sprabha5/High-Voltage-Isolated-Differential-Probe/Publication/Publication_Research_paper.pdf

# Ultra Low-Cost High-Voltage Isolated Differential Probe for Teaching and Training

Mouli Venkata Prakash Pittala, Devi Prasad Karri, Shashi Prabha, Daniel Dsa, Little Pradhan, and Abhijit Kshirsagar

Department of Electrical Engineering, Indian Institute of Technology (IIT), Dharwad, Karnataka, India

Emails: {200020027,200020022,200020043,daniel.dsa,little.pradhan.20,kabhijit}@iitdh.ac.in

Abstract—Measurement of time-varying high-voltages is necessary in various teaching, training, and research scenarios, in domains ranging spanning multiple disciplines beyond just electric power engineering. While low voltage levels (<100V) can usually be measured directly by oscilloscopes with inexpensive passive probes, higher voltages (>400V) often require specialized probes and/or oscilloscopes which are expensive. Also, most oscilloscopes lack galvanically isolated channels, which adds further challenges to measurement of multiple floating (not grounded) high voltages. Although both problems can be solved by differential high-voltage probes, these are quite expensive and not cost-effective for teaching laboratories where large numbers of such probes may be needed. This paper presents a novel, inexpensive isolated high-voltage differential probe intended for use in undergraduate and graduate labs in Power Electronics, Electric Machines and Drives, Renewable Energy, etc. It is designed for input voltages up to 600V with a bandwidth of 350KHz. The design is self-contained with a removable lithium-ion battery and is designed to directly interface to a standard oscilloscope. The design also includes gain and offset correction for periodic calibration. Simulation results were validated using a preliminary hardware prototype, following which a compact version was created with optimized layout. This design is found to be excellent for cost-sensitive applications including universities, makerspaces, and startups and industries.

Index Terms—High Voltage (HV) measurement, Differential probe, Isolation amplifier, Teaching and Training

I. INTRODUCTION
High-voltage signals are common in diverse applications spanning power electronics, electric drives, renewable energy systems, and high-voltage equipment. High voltages are also common in many consumer electronics that contain large displays or motor drives. Advancements in power electronics and newer wide-band-gap semiconductors have spurred a move to higher system voltages. As an example, within two decades, electric vehicles have moved from 48V or 96V onto 400V and now even 800V systems [1]. Solar photovoltaic systems, which were once limited to 400V, are trending over 1500V [2]. Measuring such time-varying high voltages is essential

This work was partially supported through Startup Research Grant (SRG/2020/002232) from the Science and Engineering Research Board (Department of Science and Technology, Government of India) and TiHAN Scientific and Industrial Research Organization (SIRO) by the Department of Scientific and Industrial Research.

not only for product development, research and testing, but also in teaching and training. The most common method for measuring such time-varying high-voltage signals is to use an oscilloscope with a dedicated high-voltage probe. In addition, since many of these high voltages are floating (i.e. not referenced to the common earth ground), it is necessary to use a differential probe. Additionally, if multiple voltages with different references are to be captured on a single oscilloscope, then the probes may need to be galvanically isolated as well [3]. To meet these stringent requirements, a number of specialized high-voltage probes have been developed. Most of these commercially available probes are quite expensive (well over USD 1000) [4]. Recently, optically isolated high-voltage high-bandwidth probes have been introduced [5], [6] with even better performance and prices to match (>USD 10,000). These are well out of reach for cost-sensitive buyers such as educational labs, maker-spaces, hobbyists, and earlystage hardware startups, hence there is a need for a lower bandwidth, lower voltage solution and cost-effective solution for this target market.
The dual differential probe presented in [7] has a 10MHz bandwidth and 7.3V/ns slew rate using high-performance analog amplifiers. The frontend uses carefully designed resistive dividers to attenuate the voltage appearing at the input of the op-amp. This design is not truly isolated and the dependence on very-high bandwidth op-amps drives up the BOM cost. Further, for lower voltages the attenuation cannot be lowered by bypassing resistors since the probe is not truly isolated. A similar approach, without galvanic isolation, is developed in [8], [9].
True galvanic isolation is desirable particularly for limiting common-mode noise, especially in high slew-rate applications like WBG measurements. Here, analog-to-digital conversion followed by optical transmission of the digital data yields the best performance [10]. However, the high sampling rate required, (along with the complexity of recovering the signal on the other end on a host device with GUI software) drives up the cost.
In [4] a high common-mode voltage active differential probe is presented that allows a standard oscilloscope to display and quantify waveforms in circuits . It supports bandwidths up
979-8-3503-1057-3/23/$31.00 ©2023 IEEE | to 100 MHz and can reliably measure differential voltages

up to 1000 V AC and 1400 V AC/DC. In [11] a novel fiber-coupled sensor utilizing the Pockels effect in lithium niobate crystal enables direct, contactless, and high-bandwidth (GHz to DC) measurement of High Voltage (45kV) through light modulation, eliminating voltage dividers and physical connections, ideal for isolated and unobtrusive voltage sensing in various applications.
This paper presents a much lower cost, galvanically isolated probe primarily for educational use. True galvanic isolation makes it possible to measure multiple floating voltages simultaneously on one oscilloscope - for example when measuring three phase voltages and one DC-link voltage in an inverter-fed drive; or primary and secondary voltages on a transformer, etc. Voltage levels in such applications are usually 400V (threephase) or lower; hence the proposed design is targeted for 600V. Switching voltages are or the order of few tens of kilohertz, hence a system bandwidth of 300kHz is used. The ‘high’-side of the probe is powered by a removable, rechargeable lithium ion battery, making it self contained. Finally, the probe incorporates gain and offset correction circuits to improve the accuracy of differential voltage measurements using potentiometers, again keeping cost low. The probe presents high input impedance and minimizing adverse loading effects on the measured circuit, ensuring the preservation of signal integrity during analysis.

II. PROPOSED HIGH VOLTAGE PROBE WITH ISOLATION

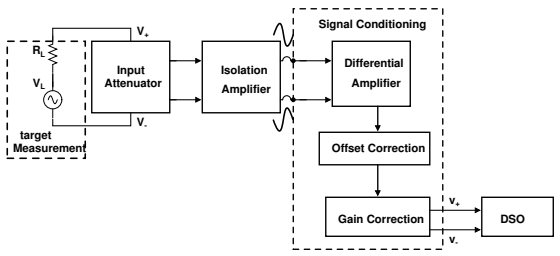
[picture p3: figure]
Differential; Amplifier; Gain Correction; DSO; Isolation; Offset Correction; Input; target Measurement; Attenuator; Signal Conditioning

Fig. 1. Block diagram of the proposed high voltage probe
Fig 1 illustrates the block diagram of the proposed HV probe. The design consists of an attenuator stage, followed by an isolation stage and a differential amplifier. The attenuator stage is responsible for reducing the voltage level, while the isolation stage ensures capacitive isolation between the probe and the measurement circuit. The differential amplifier is used to achieve ground referencing and amplify the signal. Furthermore, the design includes an offset correcting circuit to enable DC level shift and a gain correcting circuit. The probe achieves a magnification factor of 250x by maintaining unity gain correction. The proposed probe can provide isolation up to a voltage rise of 2100V, as the isolation amplifier used in the design supports such high isolation levels.
A. Attenuator
The input range of the isolation amplifier is limited between +300mV and -300mV, and therefore the high input voltage needs to be attenuated to the desired range. As shown in

Fig 2, the attenuator circuit consists of eight series-connected 250kΩ resistors and one 1kΩ resistor. The input voltage across the 1kΩ resistor is then fed to the isolation amplifier. The attenuation factor can be calculated using the following equation:

Attenuation factor =

Rinput

Rtotal + Rinput

(1)

where Rtotal is the total resistance of the attenuator circuit (8 x 250kΩ) and Rinput is the resistance across which the input voltage is applied (1kΩ). This yields an attenuation factor approximately equal to 2000. The input voltage range of the HV probe can be calculated as:

Input range of HV Probe = 2000 × (-300mV, +300mV) (2)

where (-300mV, +300mV) is the input voltage range of the isolation amplifier. The proposed HV probe can therefore measure input voltage signals in the range of -600V to +600V.

B. Isolation Amplifier

Isolation is provided by the AMC1301 isolation amplifier, from Texas Instruments. The AMC1301 requires a +5V power supply, which is generated using the LM7805 regulator. Fig 4 demonstrates the gain value of the isolation amplifier to be 18.6 dB, from LTspice simulation. The voltage gain is therefore 8, up to 100 KHz.
Fig 5 shows the LC low-pass filter employed in the power supply to eliminate undesired noise signals before they reach the isolation amplifier. To ensure that only DC signals are permitted, the cutoff frequency of the LC low-pass filter is set as low as possible. The specified cutoff frequency of the LC filter is as follows.
C = C1 + C2 + C3 | (3)
= 470µF + 0.1µF + 0.01µF
= 470.1µF

Now, using the combined capacitance (C = 470.1µF) and the value of the inductor (L = 1mH), the cutoff frequency of the LC low-pass filter using is calculated using the formula:

fc =

1
2π

√
L · C

=

1
2π

√
1mH · 470.1µF

≈

1
2π · 154.167kHz

≈ 1.03kHz (4)

C. Differential Amplifier

The initial step in the signal conditioning process as shown in Fig 1 involves utilizing a differential amplifier to convert the differential input into a ground-referenced signal which allows the signal to be fed into an oscilloscope for further analysis. The construction of a differential circuit is demonstrated in Fig 2, which employs an LF356 integrated circuit operational amplifier (op-amp) for this purpose.

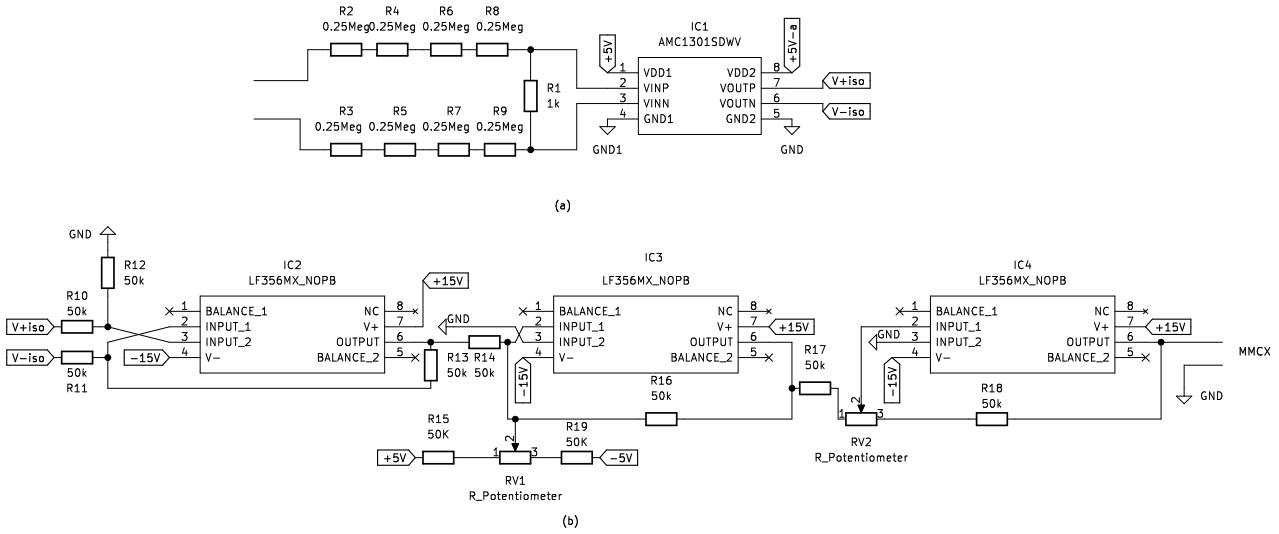
[picture p4: figure]

Fig. 2. (a) Circuit diagram of attenuator and isolation amplifier stage. (b) Circuit diagram of differential, offset correction, and gain correction stage.

Fig. 3. (a) 5V Regulator. (b) Representation of -5V generation.

10⁰ | 10¹ | 10² | 10³ | 10⁴ | 10⁵ | 10⁶
Frequency

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
Magnitude (dB)

Magnitude Response

Fig. 4. Gain VS Frequency plot of isolation Amplifier from LTspice simulation.

D. Offset Correction

The expected output will have a DC offset at higher values of input voltage as shown in Fig 6. To address this issue, a correction is required by adjusting the DC level. This

Fig. 5. LC low pass filter

adjustment is achieved using a simple summing amplifier, where the DC level can be finely tuned using a trimmer. The actual circuit for the summing amplifier is depicted in Fig 2 as part of the combined circuit design. Additionally, the DC level shift can be adjusted both positively and negatively. The generation of +5V and -5V DC voltages required for this purpose is illustrated in parts (a) and (b) of Fig 3, respectively. These voltage sources play a crucial role in achieving the desired DC level adjustment in the signal conditioning circuit.

E. Gain Correction

In the context of signal conditioning for high-frequency applications, it is observed that as the gain of the isolation amplifier decreases, above the 100 kHz range. To address this issue and enable proper gain correction above 100 kHz, a gain correction circuit is required. As a solution, an inverting amplifier was incorporated as a crucial component of the signal conditioning circuit. This circuit, illustrated in Fig 2, includes a trimmer that allows for manual adjustment of the gain. Implementing the gain correction stage ensures that the signal conditioning system can effectively compensate for attenuations and ensure accurate signal amplification at higher frequencies.

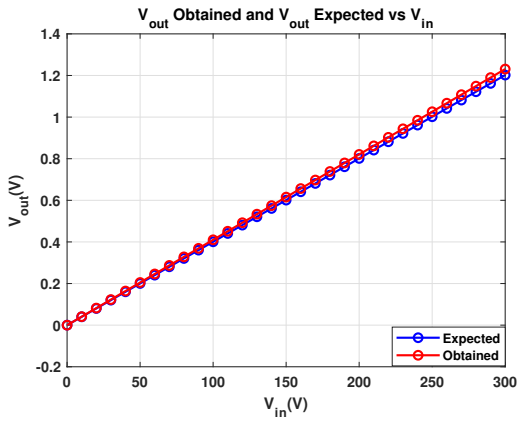
[picture p5: figure]
Vin(V); Vout(V); Vout Obtained and Vout Expected vs Vin; Expected Obtained

Fig. 6. Gain Error

III. SIMULATION RESULTS

A simulation has been done using LTspice software to validate the proposed high voltage probe design. The simulation outputs of each stage when subjected to a 300V peak sinusoidal input signal of frequency 50Hz is shown in Fig
7. The initial signal is attenuated 2000 times through the attenuator, resulting in a corresponding plot as shown in the graph. Subsequently, the attenuated signal is amplified 8 times by the isolation amplifier. Further, the differential plot showcases the ground-referenced version of the amplified signal.
Moving forward, the offset correction stage demonstrates the inverted signal with appropriate offset correction, while the gain remains unchanged. Following this stage, the final output plot depicts a phase difference of 0 compared to the input, due to the re-inversion of the signal. Consequently, the final output signal is 250 times attenuated when compared to the initial input signal.
The simulation results presented in Fig 7 highlight the effective signal processing stages involved, including attenuation, amplification, inversion, and offset correction, which leads to the final desired output.

IV. HARDWARE RESULTS

This section describes the results obtained after implementation of the proposed HV probe design. The attenuator output is shown in Fig 8 when a 200 V peak-to-peak square wave input signal is applied which results in a 100 mV peak-to-peak output.

Vout,attenuator =

200
2000
= 100 mV. | (5)

Fig 9 shows the output voltage after the isolation amplifier stage, which matches with the expected value.

Vout,isolation = 8 × 100 mV = 800 mV. | (6)

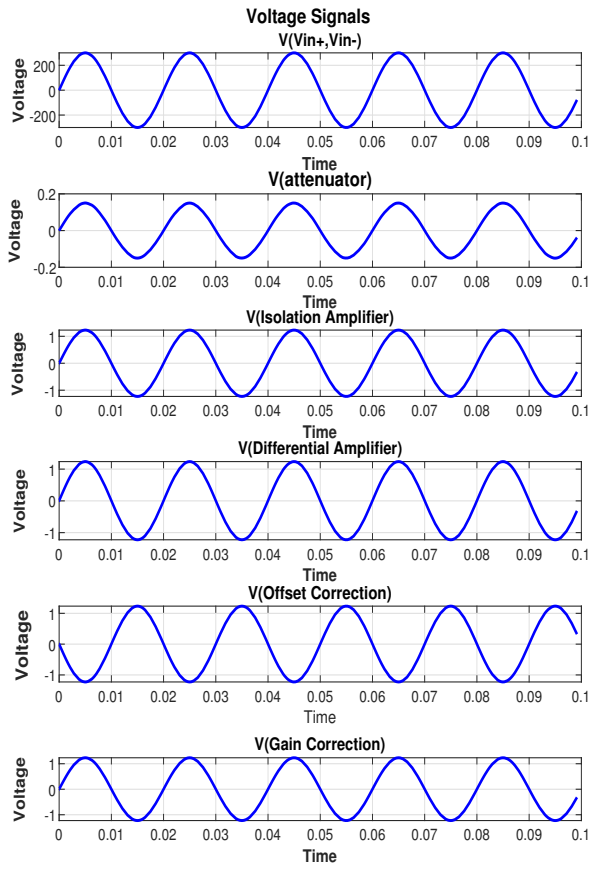
[picture p6: figure]
Time; Voltage; V(attenuator); V(Vin+,Vin-); V(Isolation Amplifier); V(Gain Correction); V(Differential Amplifier); V(Offset Correction); Voltage Signals

Fig. 7. LTSpice simulation results of each stage

Fig 10 shows the output voltage referenced to ground of the differential amplifier stage with unity gain. The expected output voltage of the differential amplifier stage should be 800 mV, whereas the obtained voltage obtained is 824 mV.

Vout,differential = 800 mV × 1 = 800 mV. | (7)

Fig 12 shows the output voltage of the offset correction stage by providing 300 mV offset. Fig 11 shows the output voltage after the gain correction stage by providing an amplification factor of 2 .

Vout, gain = 2 × 800 mV = 1.6 V. | (8)

In Fig 13, an experimental evaluation of the proposed HV probe design is presented alongside the industry standard Tektronix (P5200A) high voltage isolated differential probe. The results obtained for a square wave input signal of 200V peak-peak, 50 Hz demonstrate the results obtained from the Tektronix voltage probe and the proposed HV probe design closely match other, which serves as a compelling validation of the effectiveness and performance of the proposed HV probe design.

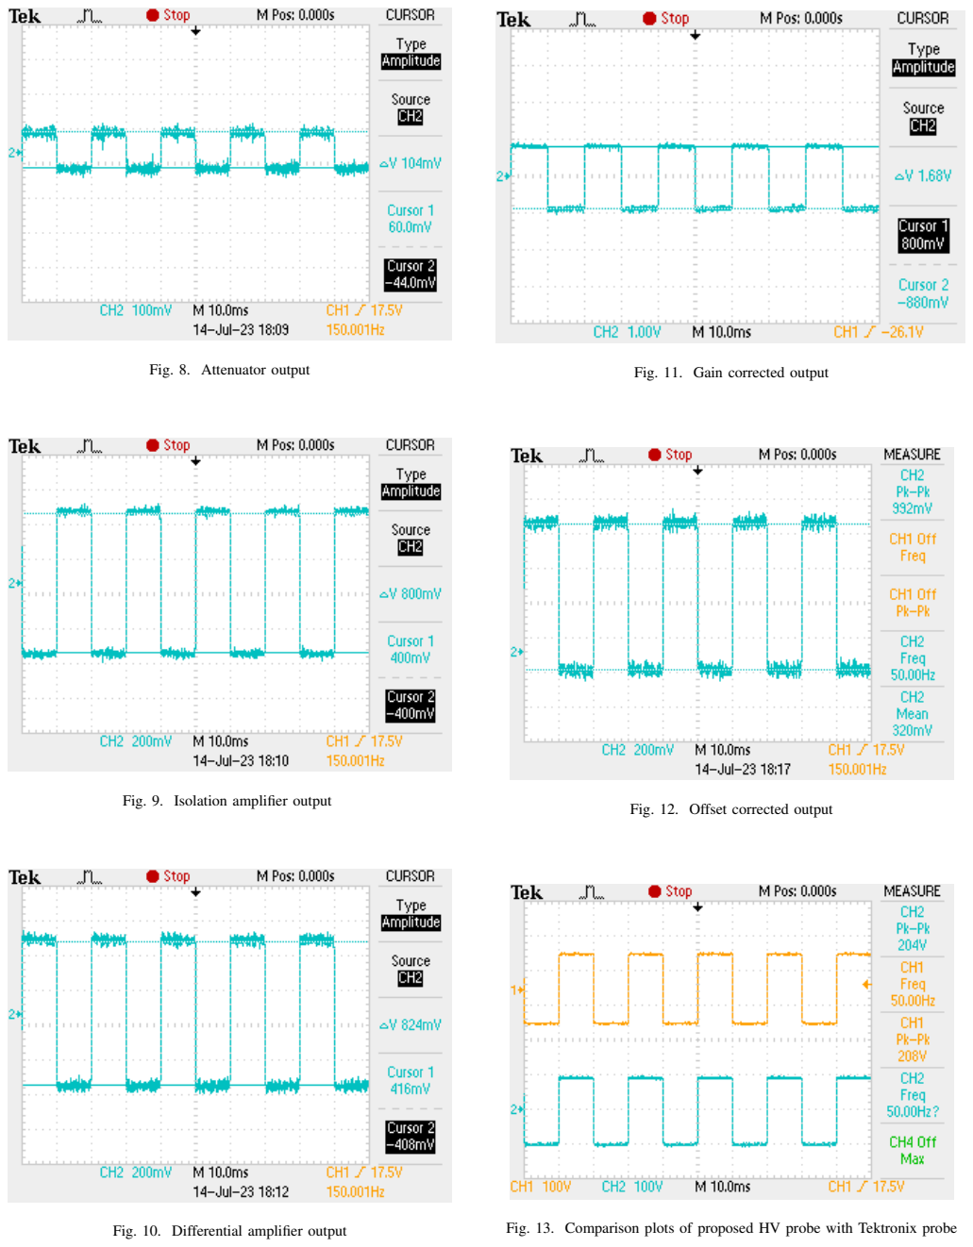
[picture p7: page 5]

Fig. 8. Attenuator output

Fig. 9. Isolation amplifier output

Fig. 10. Differential amplifier output

Fig. 11. Gain corrected output

Fig. 12. Offset corrected output

Fig. 13. Comparison plots of proposed HV probe with Tektronix probe

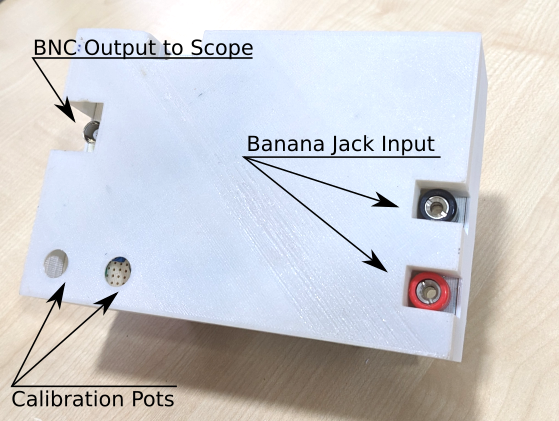
[picture p8: figure]

Fig. 14. First prototype with 3D printed enclosure showing banana-jack inputs and single BNC output. Potentiometers for calibration are accessible on the front panel

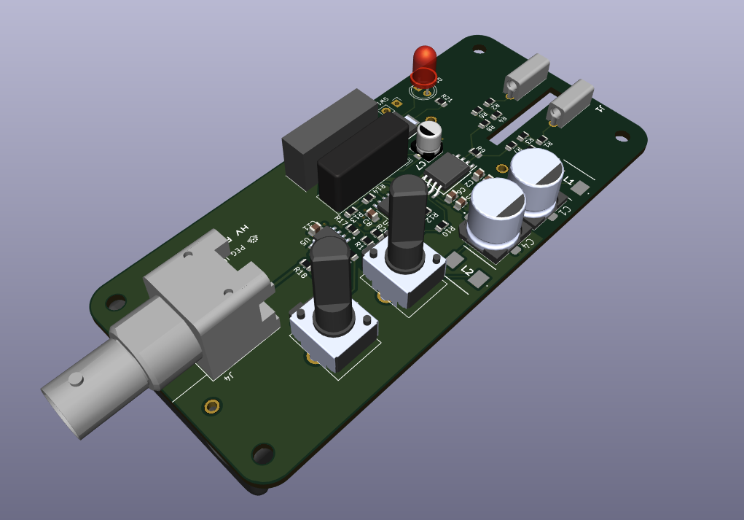
[picture p9: figure]

Fig. 15. Optimized layout with all-SMD components, clearance distances and compact design

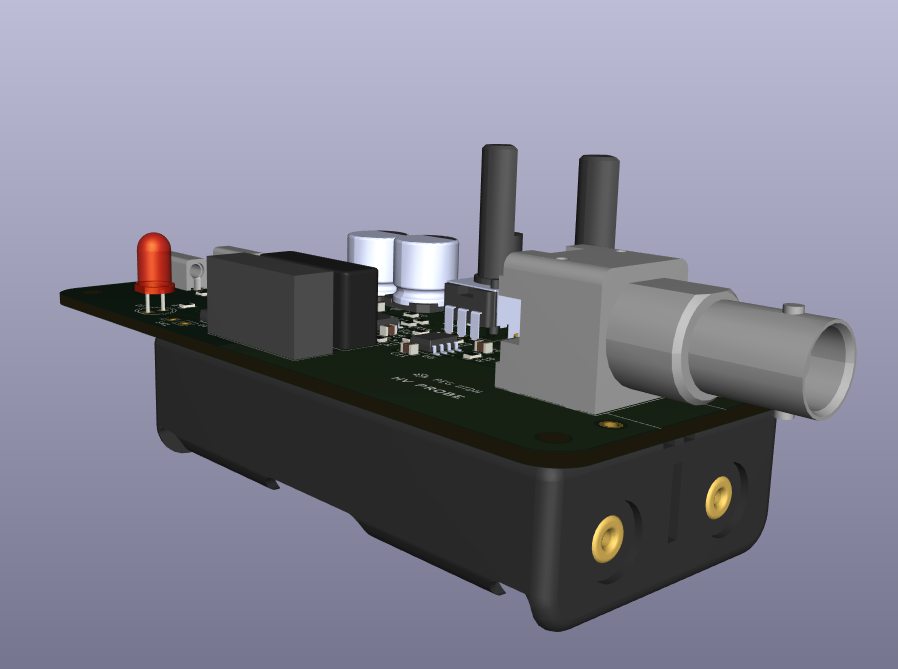
[picture p10: figure]

Fig. 16. 3D render of optimized layout sized to fit on the back of a 2S -18650 battery holder.

TABLE I
COMPARISON OF DIFFERENT HIGH VOLTAGE PROBES FOR MEASUREMENTS
Probe Type | Bandwidth | Voltage Rating [V] | Cost [$]
Isolated Probe [8] | 1 MHz | ±1500 | -
Differential Probe | 20 MHz | ±1000 | -
Testec (SI-9001) | 25 MHz | 70,700 | 350
Proposed HV Probe | 300 KHz | ±600 | 50
V. CONCLUSION
A high-voltage isolated differential probe with a unique, low-cost design that can accurately measure differential voltage signals up to 600V has been proposed. The design of the proposed probe has been validated through simulation and hardware prototype. The results obtained show that the proposed probe can provide accurate voltage measurements of high voltage differential signals with good linearity and minimal distortion, thus making it a viable cost-effective and reliable alternative for high voltage measurements in laboratory applications.

REFERENCES

[1] C. Jung, “Power up with 800-v systems: The benefits of upgrading voltage power for battery-electric passenger vehicles,” IEEE Electrification Magazine, vol. 5, no. 1, pp. 53–58, March 2017.
[2] A. Stillwell and R. C. N. Pilawa-Podgurski, “Design optimization of a 1500 v gan-based solar inverter using flying capacitor multi-level converter stages,” in 2019 IEEE Energy Conversion Congress and Exposition (ECCE), Sep. 2019, pp. 4605–4612.
[3] ABCs | of | Probes. | [Online]. | Available:
https://www.tek.com/en/documents/whitepaper/abcs-probes-primer
[4] “SI-9001 | 25 | MHz | High | Voltage | Differential | Probe | User
Manual,” | May | 2019. | [Online]. | Available: | https://docs.rs-
online.com/5db5/A700000009043281.pdf
[5] “DL-ISO High Voltage Optically Isolated Probes User Manual,” 2022.
[6] “IsoVu | Isolated | Probes | — | Tektronix,”
https://www.tek.com/en/products/oscilloscopes/oscilloscopeprobes/isovu-isolated-probes.
[7] A. Van Den Bossche and D. Bozalakov, “Two channel high voltage differential probe for power electronics applications,” in 2013 15th European Conference on Power Electronics and Applications (EPE). Lille, France: IEEE, Sep. 2013, pp. 1–6. [Online]. Available: http://ieeexplore.ieee.org/document/6634710/
[8] M. Grubmuller, B. Schweighofer, and H. Wegleiter, “A Digital Isolated ¨ High Voltage Probe for Measurements in Power Electronics,” in 2018 IEEE 27th International Symposium on Industrial Electronics (ISIE), Jun. 2018, pp. 791–796, iSSN: 2163-5145.
[9] ——, “Development of a Differential Voltage Probe for Measurements in Automotive Electric Drives,” IEEE Transactions on Industrial Electronics, vol. 64, no. 3, pp. 2335–2343, Mar. 2017, conference Name: IEEE Transactions on Industrial Electronics.
[10] P. S. Niklaus, R. Bonetti, C. Stager, J. W. Kolar, and D. Bortis, “High- ¨ bandwidth isolated voltage measurements with very high common mode rejection ratio for wbg power converters,” IEEE Open Journal of Power Electronics, vol. 3, pp. 651–664, 2022.
[11] M. Heino, “Fiber optic high voltage probe,” in Digest of Technical Papers. 12th IEEE International Pulsed Power Conference. (Cat. No.99CH36358), vol. 1, June 1999, pp. 250–252 vol.1.
