sprabha5/High-Voltage-Isolated-Differential-Probe/Lab_Presentations/EE311 EDL Spring 2023 HV Probe_final_presentation.pdf

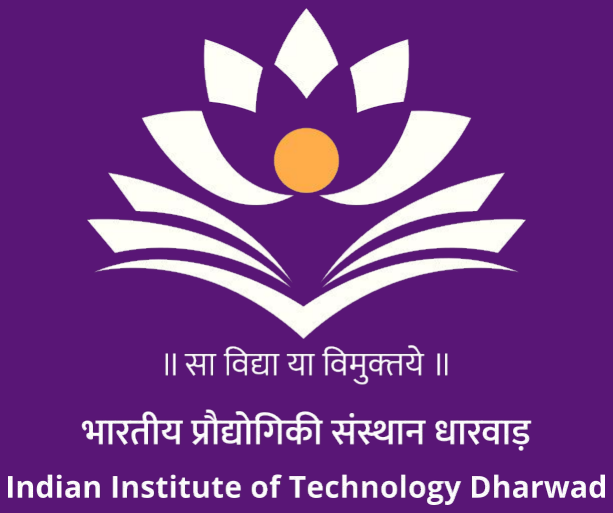
[picture p11: figure]

# High Voltage Isolated Differential Probe

## - Voltage Range: 0-600V - Bandwidth: DC-125KHz - Isolation Voltage Rating: 1000V - Input Connector: Banana jack type - Output Connector: BNC - Operating Temperature: 10°C to 50°C

## - Power Source: External,Batteries

IITDH

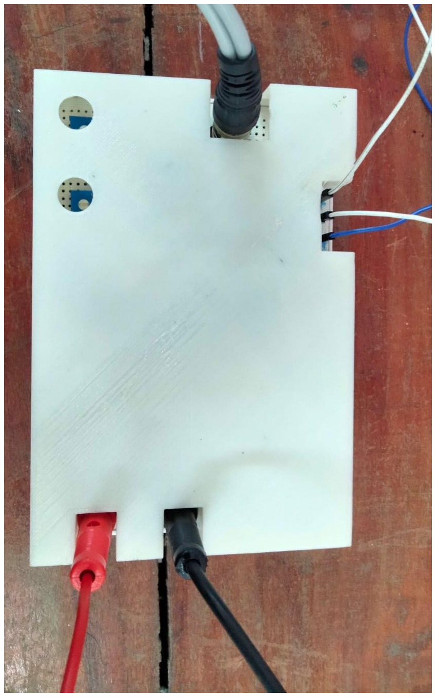
[picture p12: figure]

27-Jan-23

# Wish specifications:

# System Block diagram

IITDH

27-Jan-23

## Input Attenuator Stage

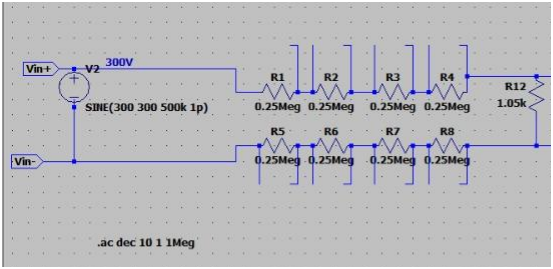
[picture p13: figure]

### Attenuation: 1/2000

## Isolated Amplifier Stage

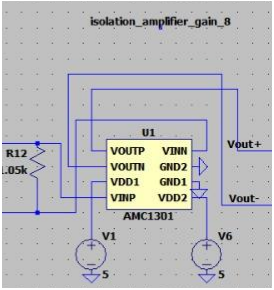
[picture p14: figure]

Bandwidth: 1MHz
gain: 8
Vdd: -0.3 to 7V
Input voltage range : 330mV (calculated by simulations)

## Signal Conditioning

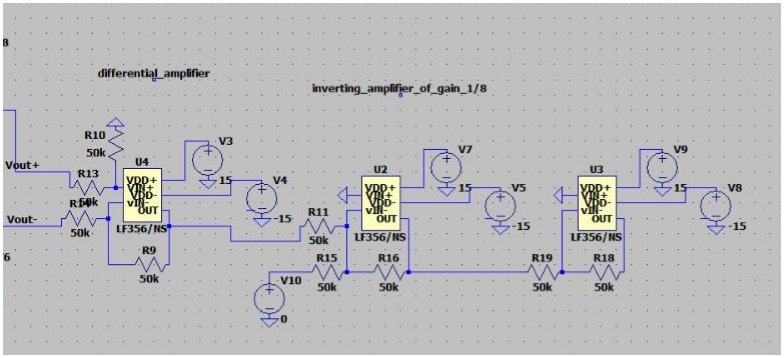
[picture p15: figure]

IC (LF356)
Differential amplifier : making output single ended
Inverting amplifier : used for trimming of gain and offset correction

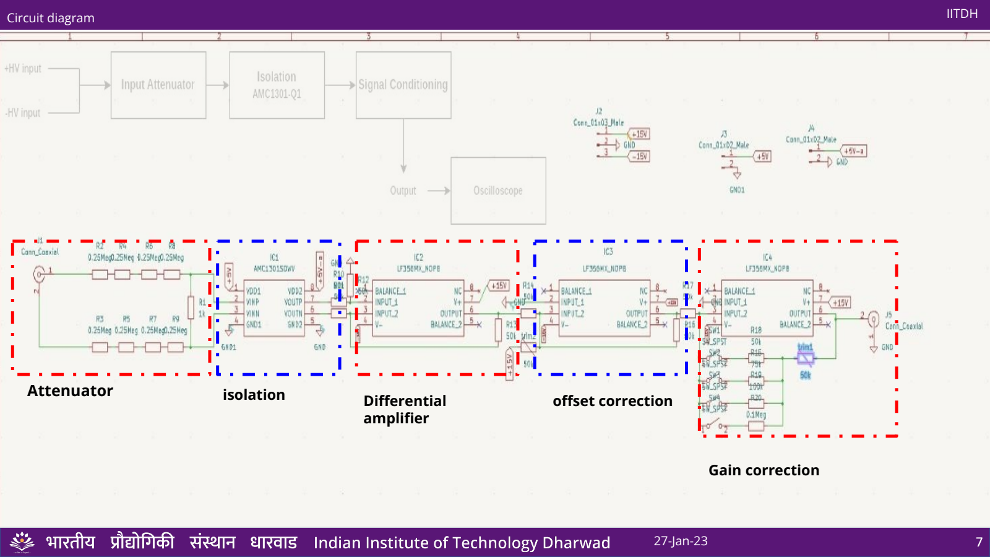
[picture p16: page 7]

Circuit diagram | IITDH

27-Jan-23

Attenuator | isolation | Differential amplifier
offset correction

Gain correction

## At an input of 200rms

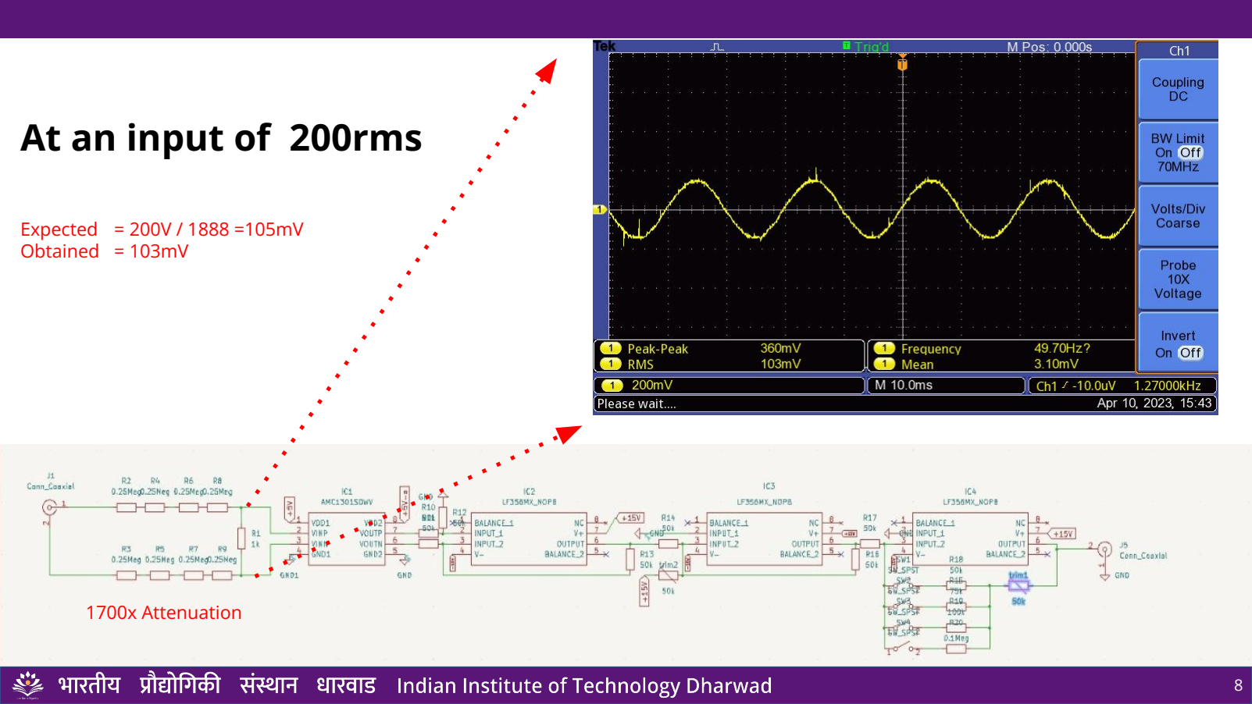
[picture p17: page 8]

1700x Attenuation

Expected = 200V / 1888 =105mV Obtained = 103mV

## At an input of 200 mv pp to isolation amplifier at

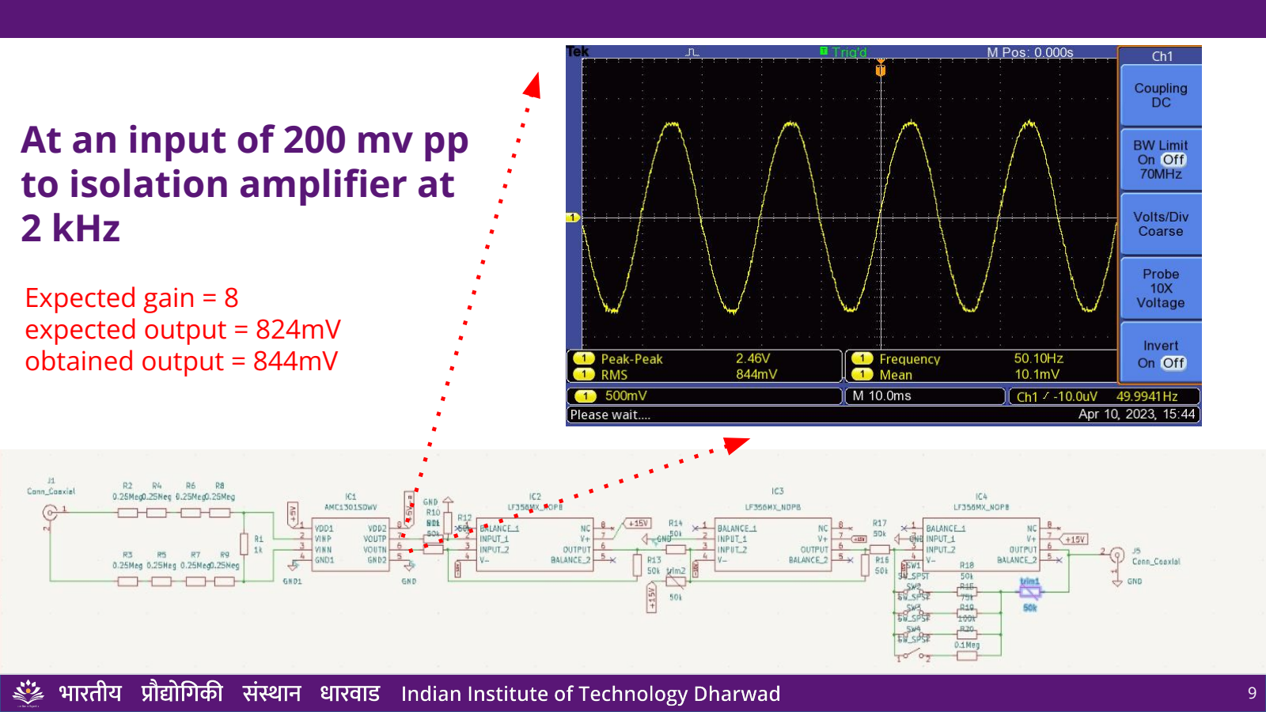
[picture p18: page 9]

## 2 kHz

Expected gain = 8
expected output = 824mV
obtained output = 844mV

## Differential Amplifier

### At an input of 5V pp

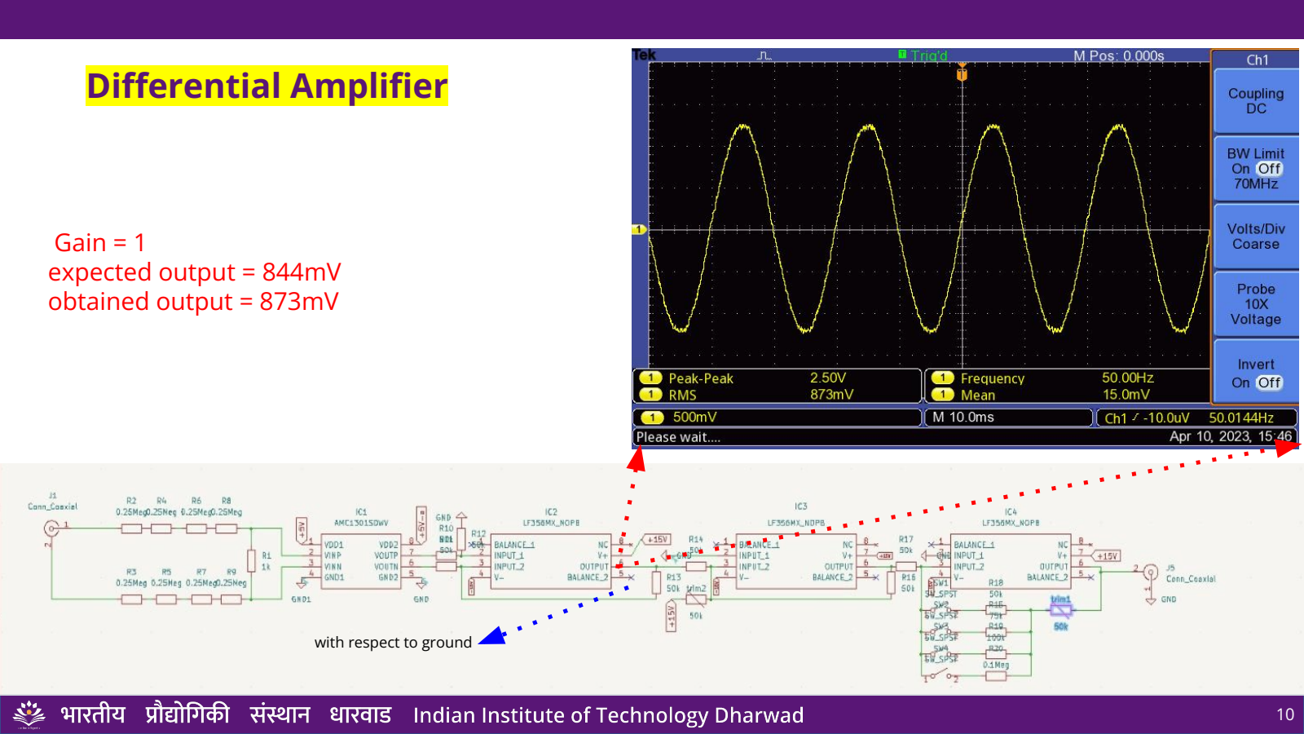
[picture p19: page 10]

with respect to ground

Gain = 1
expected output = 844mV
obtained output = 873mV

## At an input of 10V pp

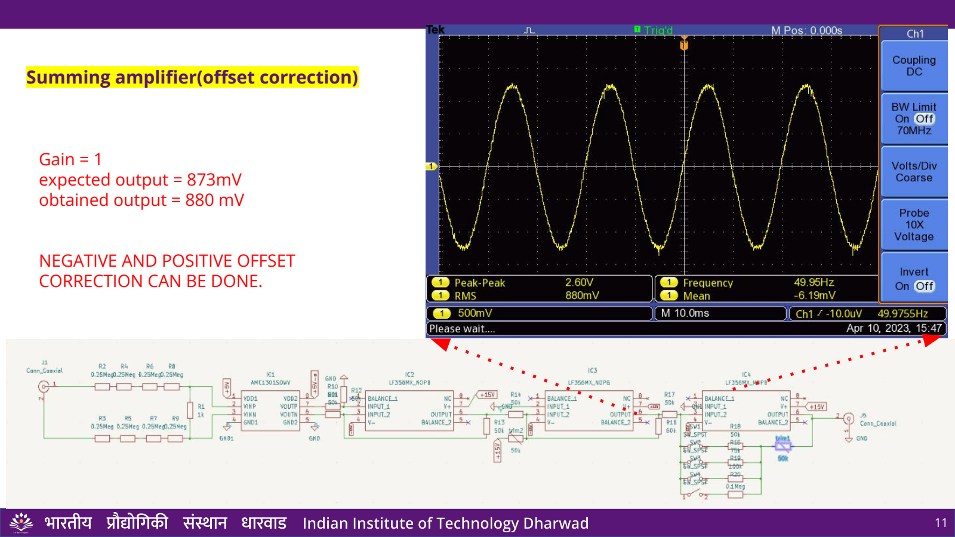
[picture p20: page 11]

Summing amplifier(offset correction)

Gain = 1
expected output = 873mV
obtained output = 880 mV

NEGATIVE AND POSITIVE OFFSET CORRECTION CAN BE DONE.

### Inverting amplifier (Gain Correction)

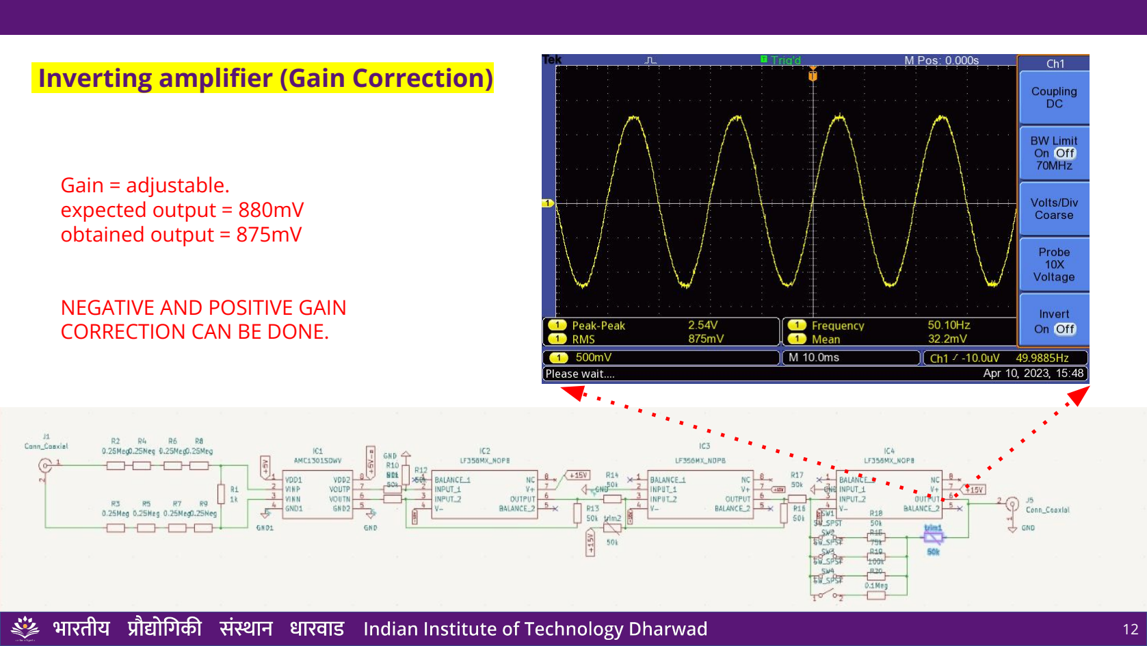
[picture p21: page 12]

Gain = adjustable.
expected output = 880mV
obtained output = 875mV

NEGATIVE AND POSITIVE GAIN CORRECTION CAN BE DONE.

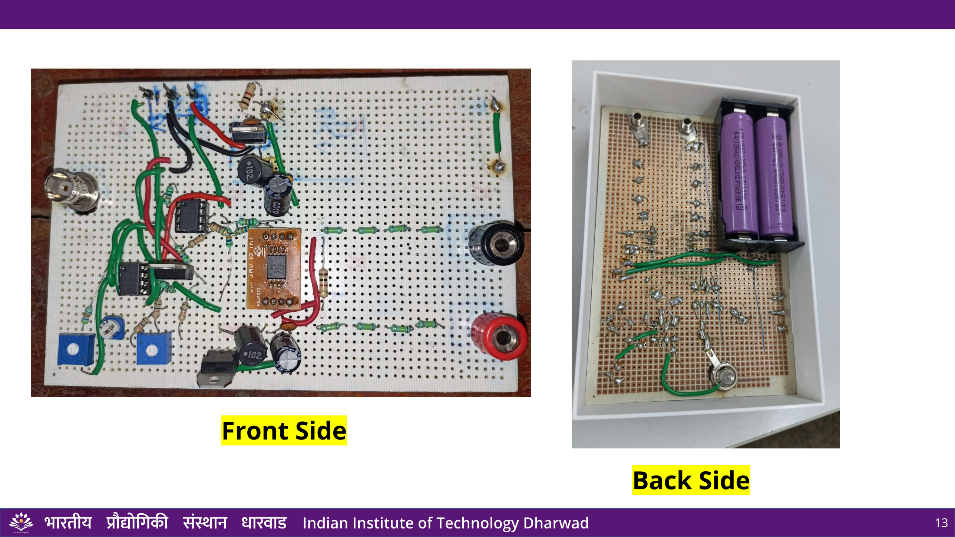
[picture p22: page 13]

## Front Side Back Side

# THANK YOU
