sprabha5/High-Voltage-Isolated-Differential-Probe/Lab_Presentations/First_presentation.pdf

## High Voltage Isolated Differential Probe

Team Members:

Shashi prabha | 200020043
Mouli Venkata Prakash 200020027
Devi Prasad | 200020022

Project Supervisor

Prof. Dr.Abhijit Kshirsagar
Dept. of Electrical Engineering IIT Dharwad

### EE314: EDL Project

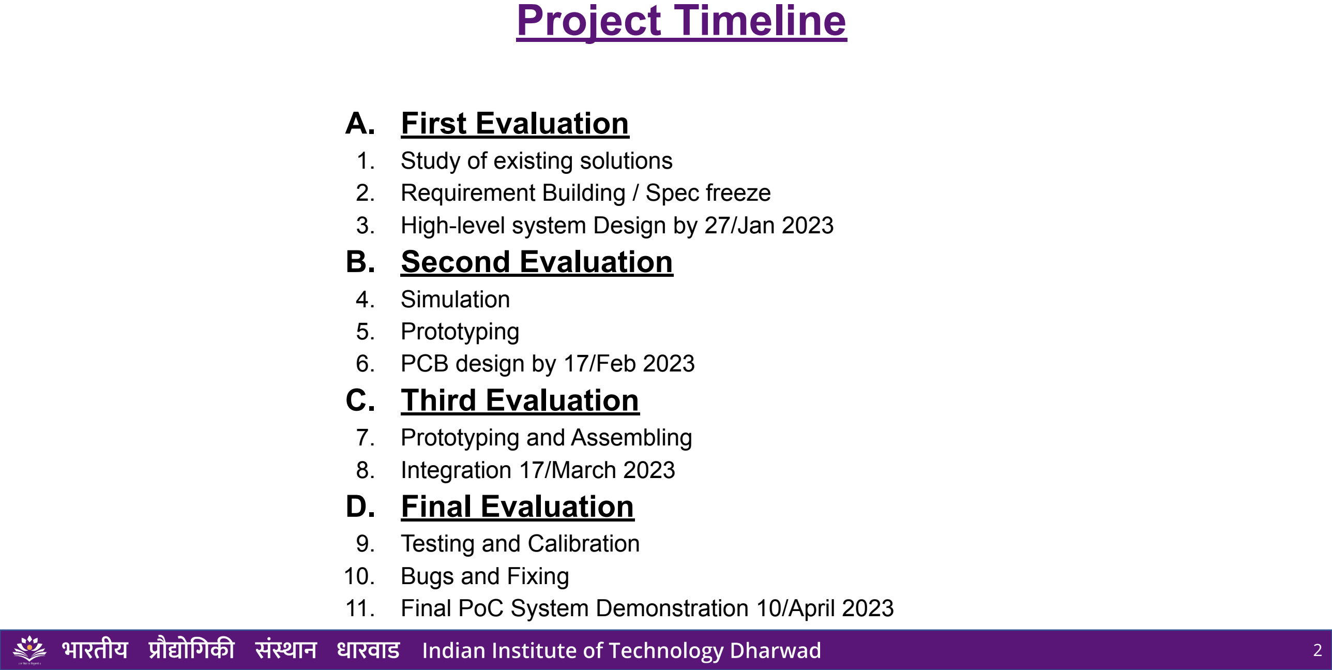
[picture p23: figure]
A. First Evaluation; 1. Study of existing solutions 2. Requirement Building / Spec freeze; B. Second Evaluation; 4. Simulation 5. Prototyping 6. PCB design by 17/Feb 2023 C. Third Evaluation; 7. Prototyping and Assembling 8. Integration 17/March 2023 D. Final Evaluation; 9. Testing and Calibration 10. Bugs and Fixing; Project Timeline

3. High-level system Design by 27/Jan 2023
11. Final PoC System Demonstration 10/April 2023

# Presentation Outline

- Problem Statement
- Target Objective
•Wish Specifications
•Isolation Techniques
•Market Survey Details
- System Level Block Diagram •Core Component
•Preliminary Design

IITDH

27-Jan-23

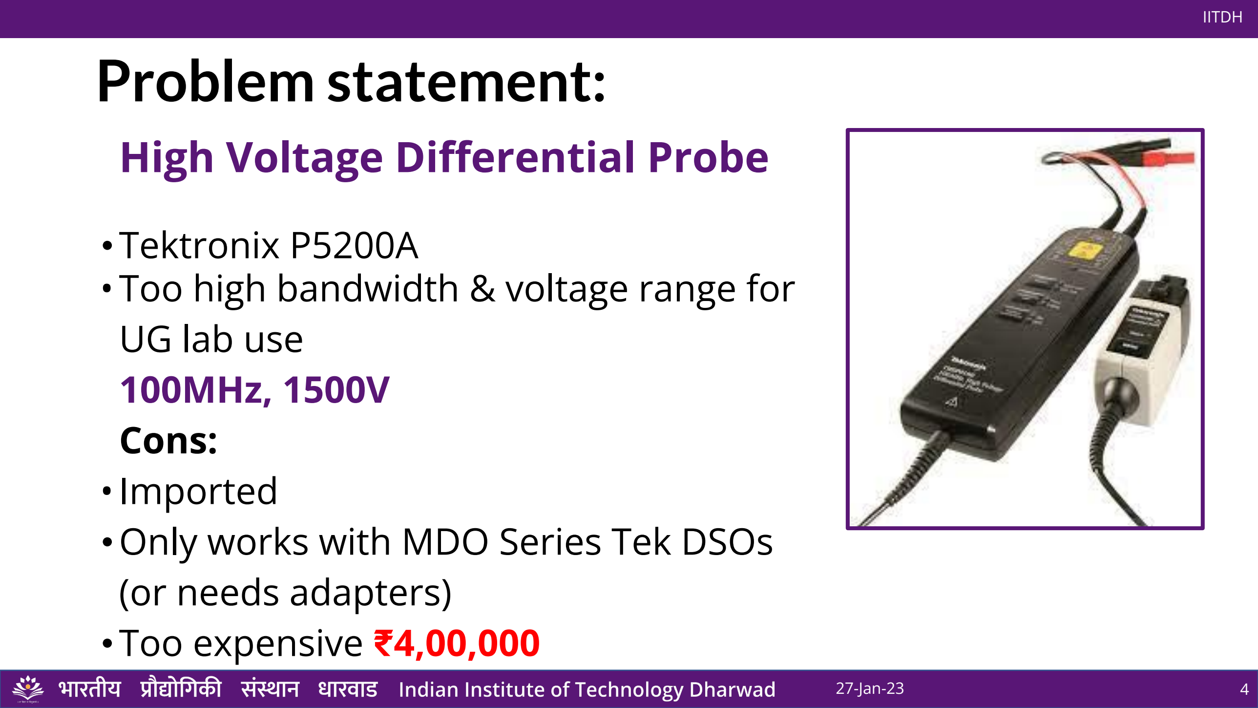
[picture p24: figure]
High Voltage Differential Probe; • Tektronix P5200A; UG lab use 100MHz, 1500V Cons: •Imported •Only works with MDO Series Tek DSOs (or needs adapters) • Too expensive ₹4,00,000; IITDH; Problem statement:; 27-Jan-23

- Too high bandwidth & voltage range for

- Voltage Range: 0-600V
- Impedance: 10MΩ
- Bandwidth: DC-5Mhz
- Common Mode Rejection Ratio (CMRR): > 65dB
- Signal Noise Ratio (SNR): > 65dB
- Isolation Voltage Rating: 1000V
- Input Connector: Banana jack type
- Output Connector: BNC
- Operating Temperature: 10°C to 50°C
- Power Source: External

IITDH

27-Jan-23

## Wish specifications:

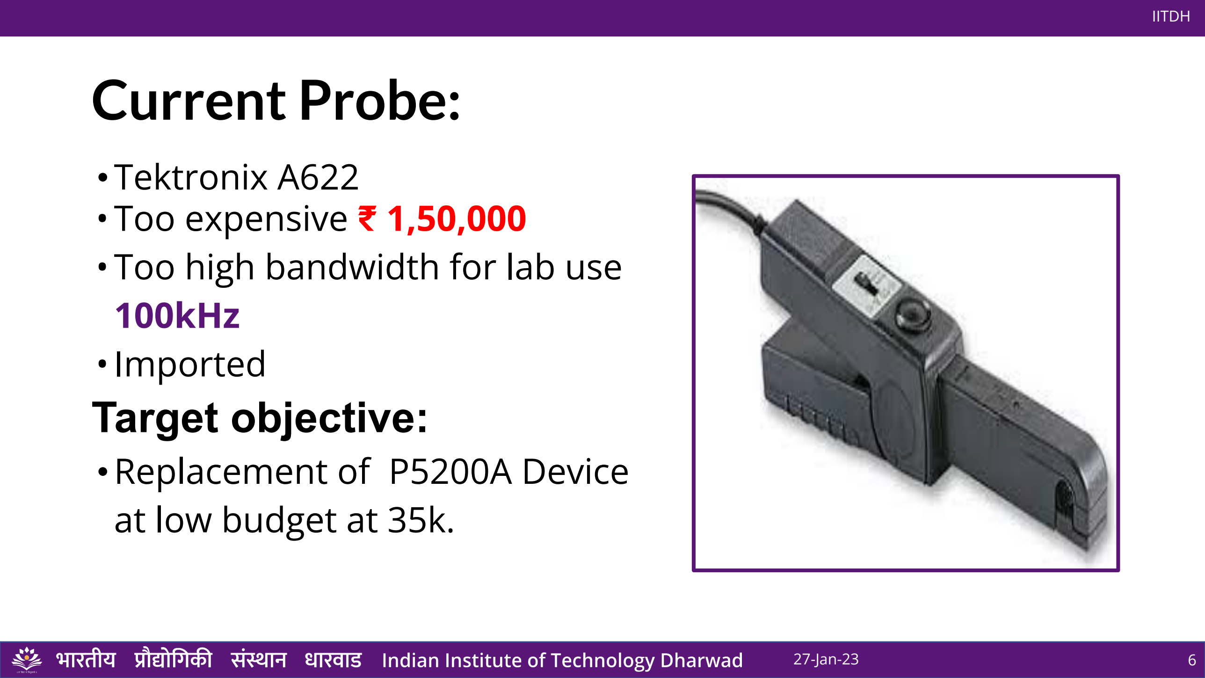
[picture p25: figure]
• Tektronix A622 • Too expensive ₹ 1,50,000 • Too high bandwidth for lab use 100kHz •Imported; Target objective:; •Replacement of; P5200A Device; at low budget at 35k.; IITDH; Current Probe:; 27-Jan-23

- RF, fibre optic, isolation mechanisms.
- RF Isolation : It is used to protect your RF components from excessive power reflection.
- RF Isolator : An RF isolator is a 2-port device that transmits microwave or radio frequency power in one direction only while blocking the signal in the opposite direction.
- RF ISOLATION TECHNIQUES:
1)grounding techniques:
- It is used to have separate supplies for analog and digital sections of the chip to isolate the analog circuits from switching noise .

IITDH

27-Jan-23

## Isolation Techniques

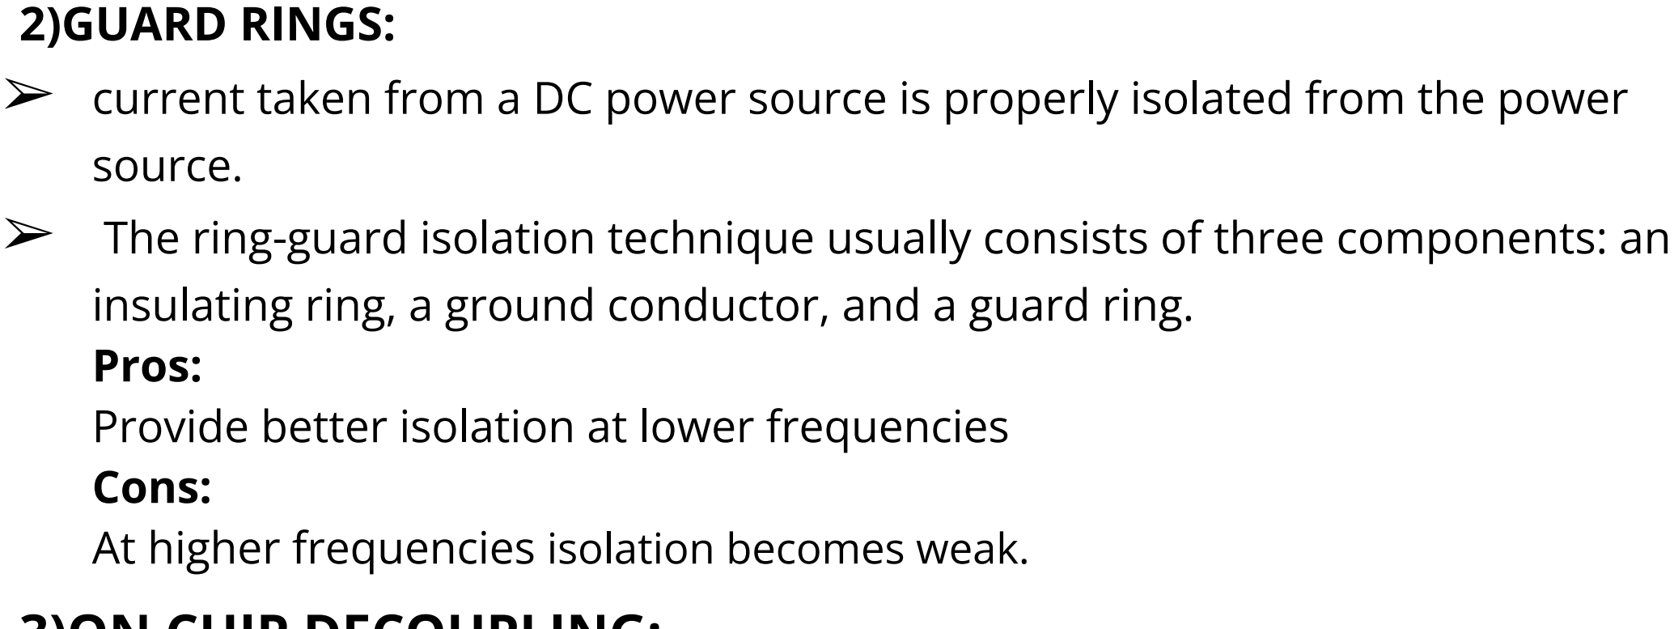
[picture p26: figure]
2)GUARD RINGS:; source.; Pros:; Cons:

- current taken from a DC power source is properly isolated from the power
- The ring-guard isolation technique usually consists of three components: an insulating ring, a ground conductor, and a guard ring.

Provide better isolation at lower frequencies

At higher frequencies isolation becomes weak.
3)ON CHIP DECOUPLING:
- It improve signal integrity and reduce unwanted crosstalk between signals.
- The technique involves isolating the circuits or devices on the IC by using a dielectric material such as silicon dioxide (SiO2) or polyimide (PI)..

27-Jan-23

### Principle:

Uses a LED or laser diode as light source,directed into a single mode optical fiber,which travels and then incident on photo
detector(photodiode),this generates electrical signal.

### Cons:

Low bandwidth,more delay,used in less input voltage,etc.

## Optical isolation

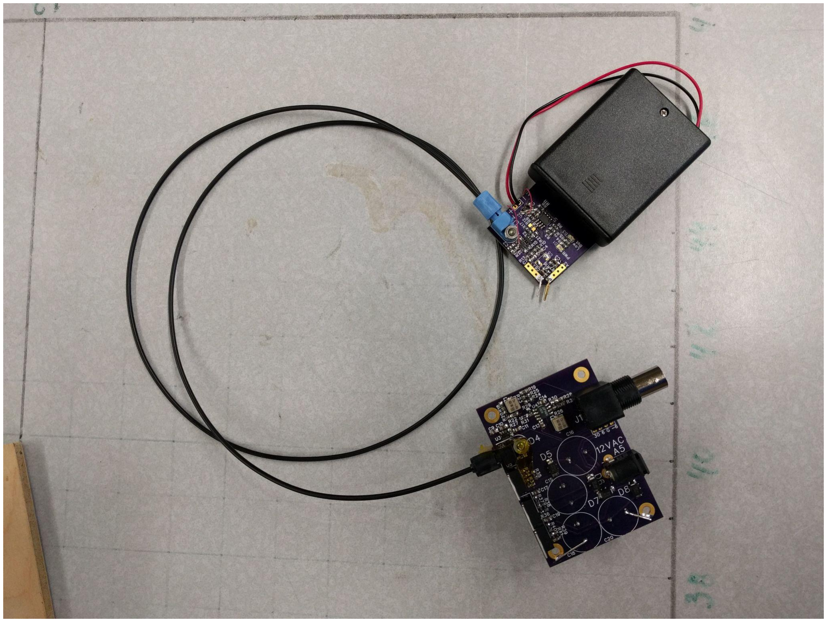
[picture p27: figure]

Fiber Optic isolated voltage probe

- 10x attenuation
- +-50V input voltage range
- used battery for power supply
- it is noisy

IITDH

27-Jan-23

## Market Survey:

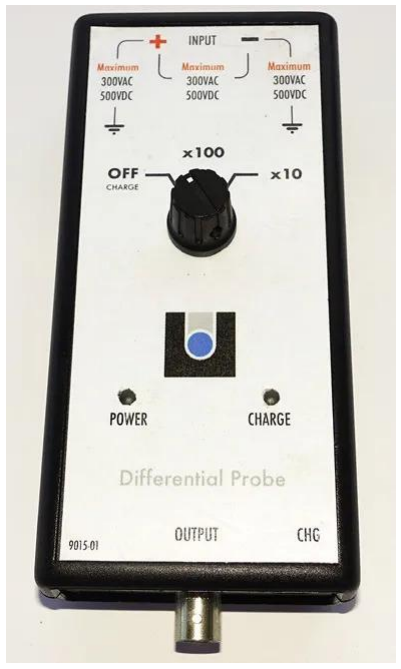
[picture p28: figure]

High Voltage differential
probe 25MHz , 400V input , same which we are
targeting but not isolated.

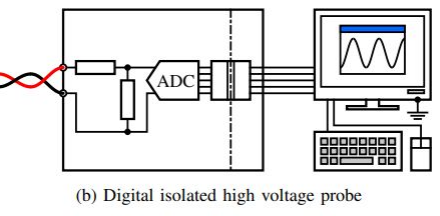
[picture p29: figure]

A Digital Isolated High Voltage Probe
In this probe isolation is provided by converting
analog signals to digital using ADC and then isolating the digital dta lines

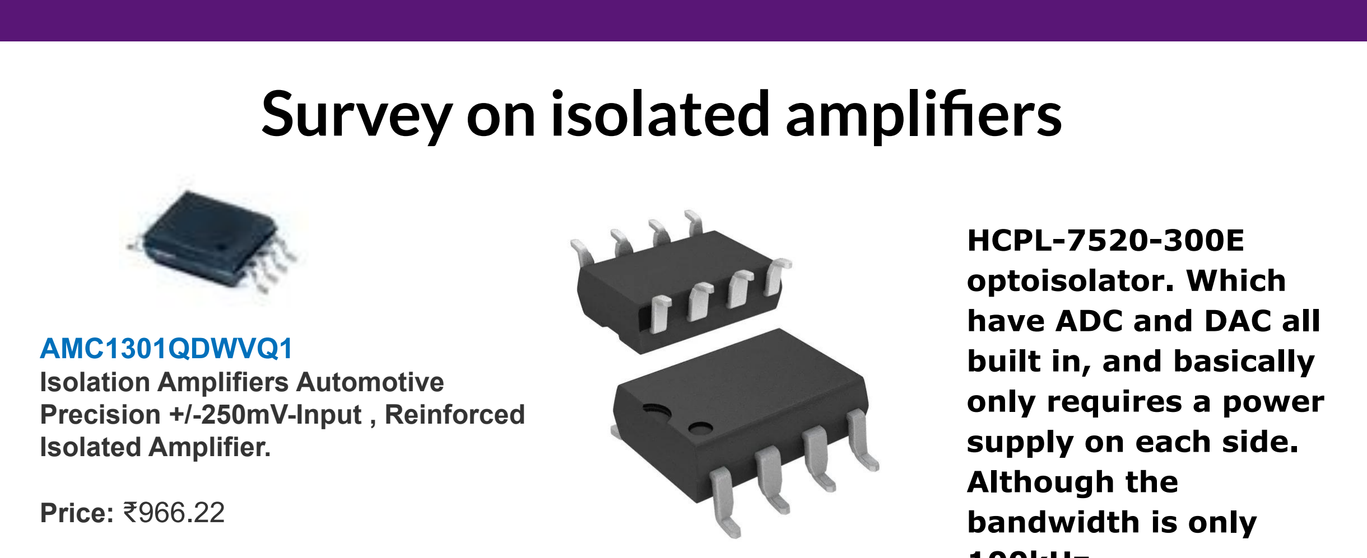
[picture p30: figure]
Survey on isolated amplifiers; AMC1301QDWVQ1 Isolation Amplifiers Automotive Precision +/-250mV-Input , Reinforced Isolated Amplifier.; Price: ₹966.22; HCPL-7520-300E optoisolator. Which have ADC and DAC all built in, and basically only requires a power supply on each side. Although the bandwidth is only

100kHz.

COST $7

## Core Component

(isolation amplifier)
AMC1301-Q1
- This barrier is certified to provide reinforced galvanic isolation of up to 7 kV peak.
- Specs
GBWP | —1000 kHz
CMRR | -— 92 dB
Operating Temperature —(-40 to 125 c)
VDD | — (–0.3 to 7) V
Input Voltage Range | — (GND1 – 6) to (VDD+ 0.5)

IITDH

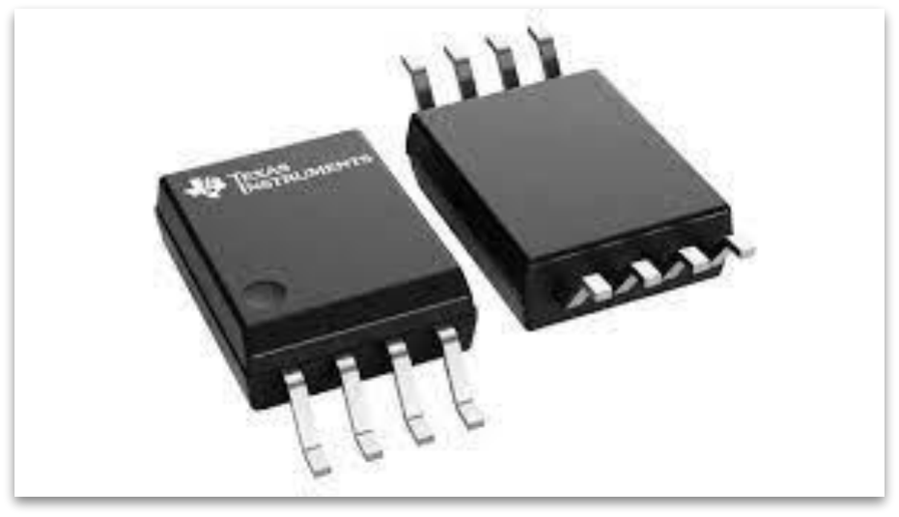
[picture p31: figure]

27-Jan-23

AMC1301-Q1

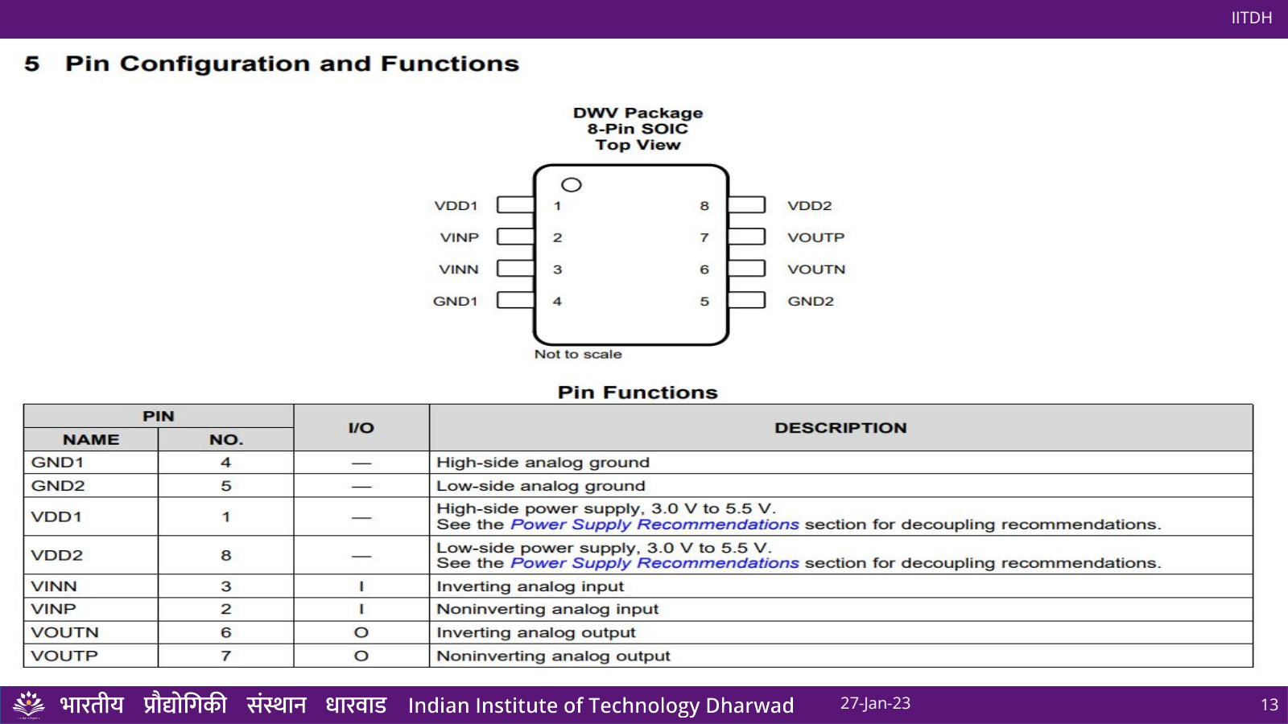
[picture p32: page 13]

IITDH

27-Jan-23

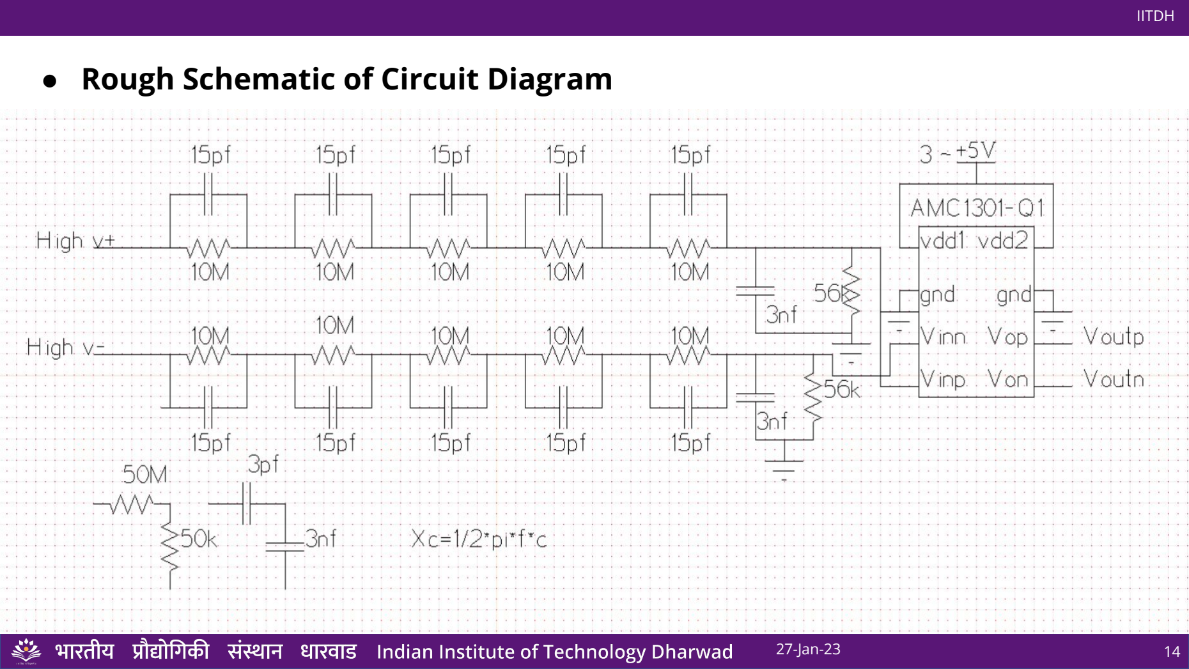
[picture p33: page 14]

IITDH

27-Jan-23

- Rough Schematic of Circuit Diagram

Second Evaluation

1. Simulation
2. Prototyping
3. PCB design by 17/Feb 2023

## Future Work

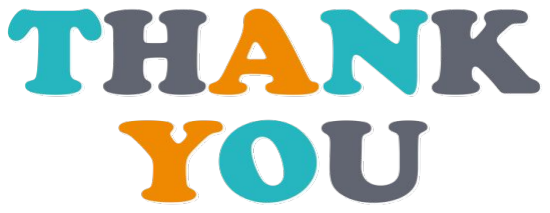
[picture p34: figure]

# System Block diagram

IITDH

27-Jan-23

Input Attenuator Stage


Attenuation: 1/2000

Isolated Amplifier Stage


Bandwidth: 1MHz
gain: 8
Vdd: -0.3 to 7V
Input voltage range : 330mV (calculated by simulations)

Signal Conditioning


IC (LF356)
Differential amplifier : making output single ended
Inverting amplifier : used for trimming of gain and offset correction

Frequency (Hz) | Gain (dB) | Trimming Values (Ohm)
1-10 | -48.14 | 51075.(45892 to 45894)
10-100 | -48.14 | 51075.(
100-1000 | -48.14
1000-10k | -48.14
10k-100k | -48.15 - -48.71
100k-1000k | -48.71 - -114.8

Trimming Values Required for gain and offset correction

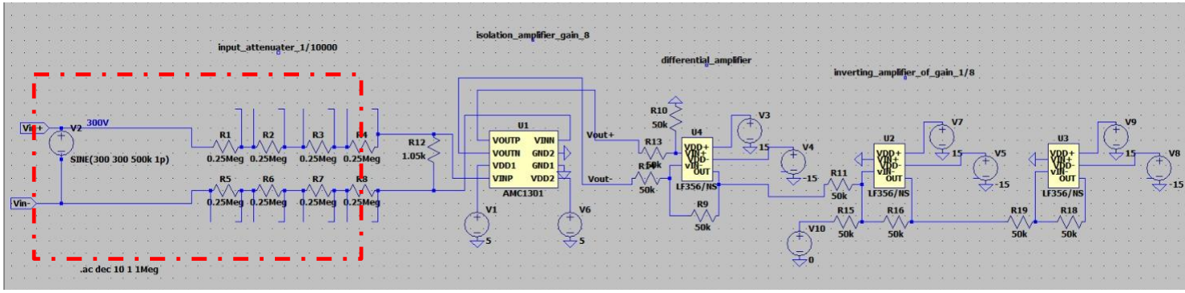
[picture p35: figure]

Stages:
Input attenuator(voltage divider)
isolation amplifier (AMC1301 IC) (bandwidth=1000kHz) differential amplifier
inverting amplifier (for gain correction)
inverting amplifier (for offset correction)

Circuit Schematic

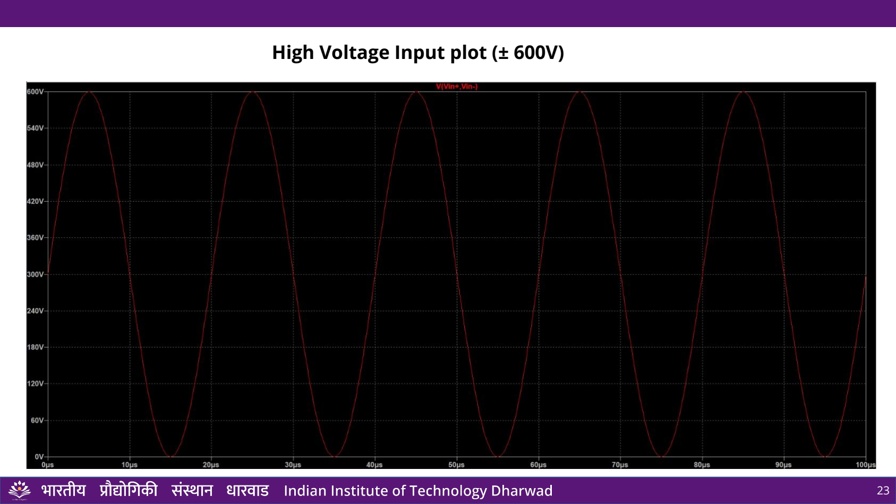
[picture p36: page 23]

High Voltage Input plot (± 600V)

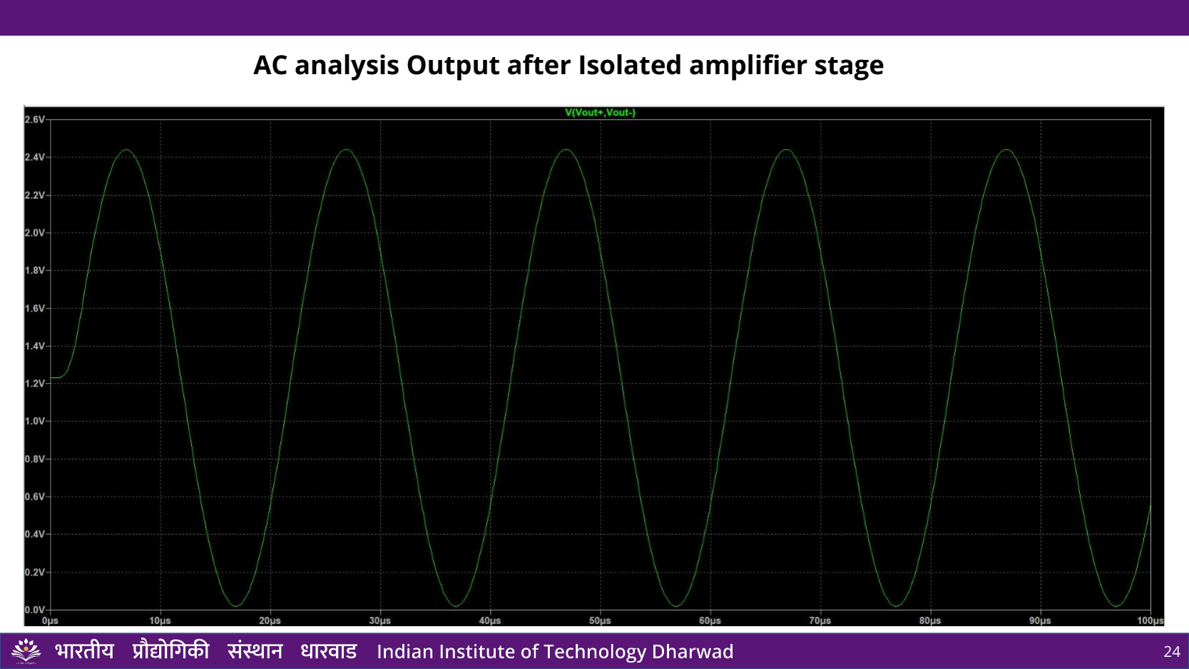
[picture p37: page 24]

AC analysis Output after Isolated amplifier stage

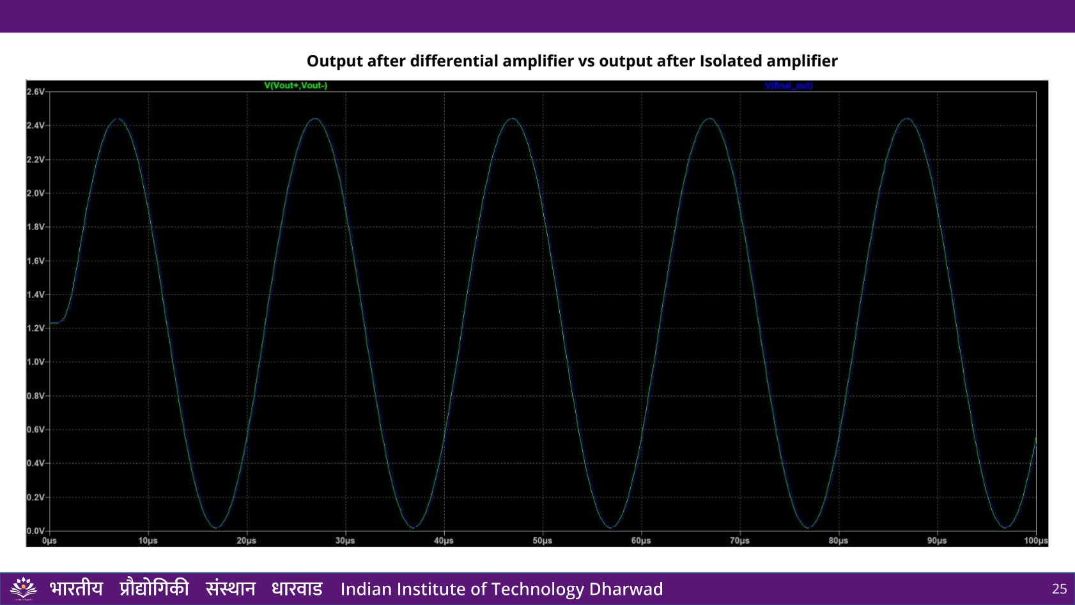
[picture p38: page 25]

Output after differential amplifier vs output after Isolated amplifier

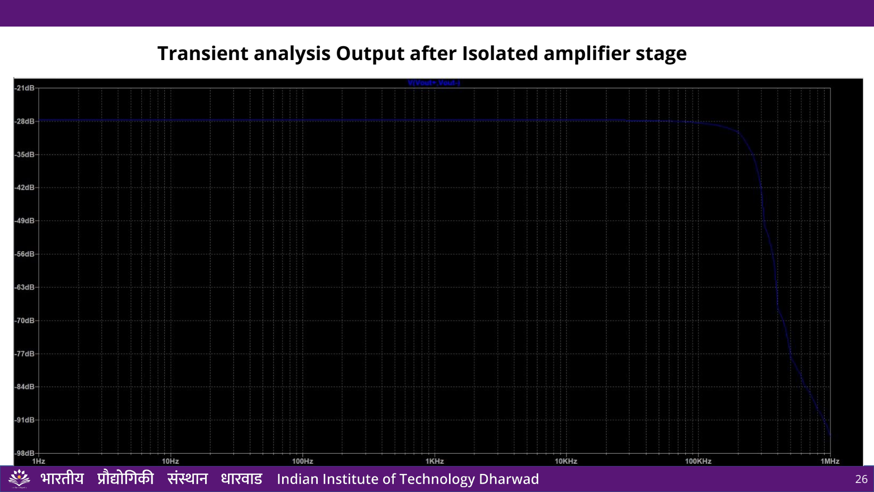
[picture p39: page 26]

Transient analysis Output after Isolated amplifier stage

## PCB schematic diagram

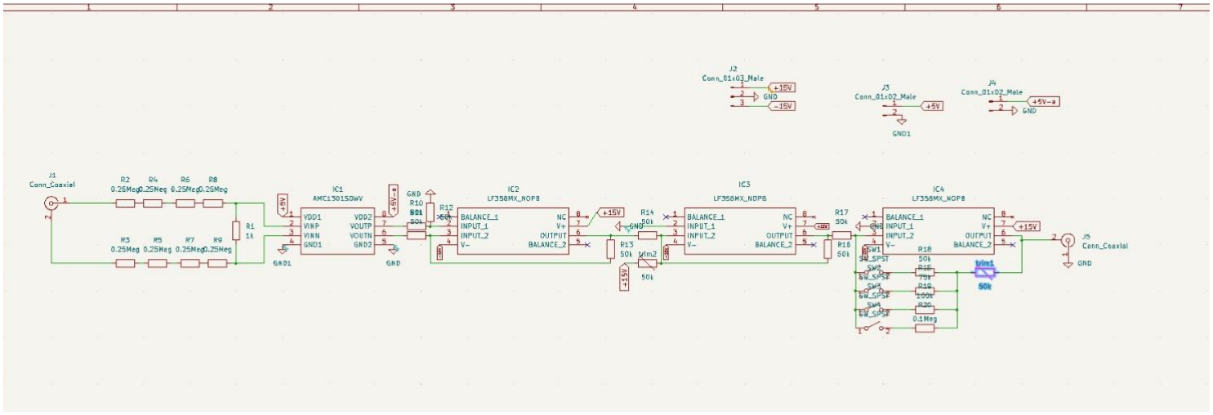
[picture p40: figure]

## PCB Design

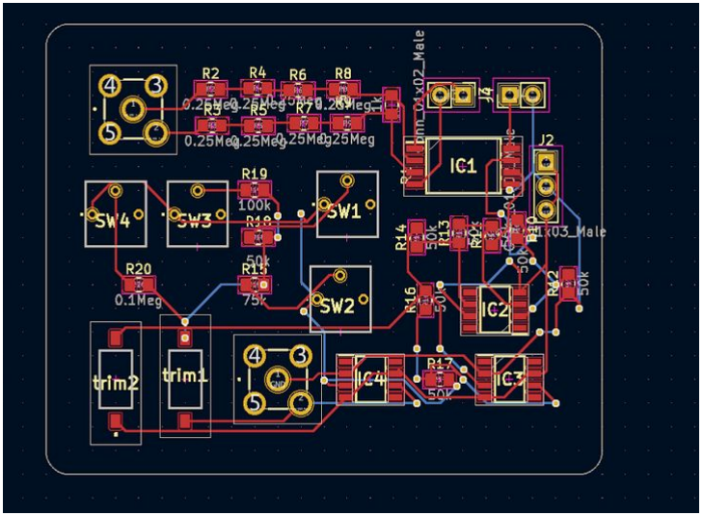
[picture p41: figure]

3D model of PCB Design

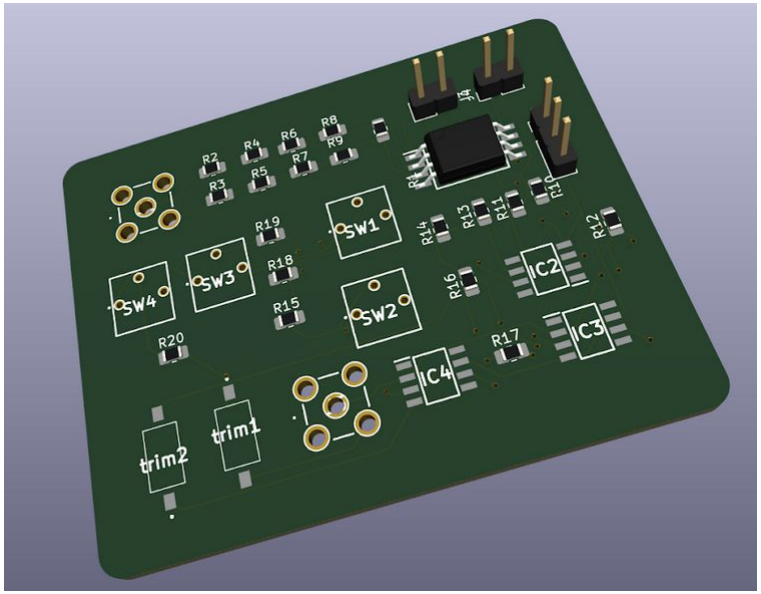
[picture p42: figure]
