sprabha5/High-Voltage-Isolated-Differential-Probe/Lab_Presentations/second_presentation.pdf

# High Voltage Isolated Differential Probe

# Team Members:

Shashi prabha | 200020043

## Mouli Venkata Prakash 200020027

Devi Prasad | 200020022

# Project Supervisor

Prof. Dr.Abhijit Kshirsagar

## Dept. of Electrical Engineering IIT Dharwad

# EE314: EDL Project Evaluation 2

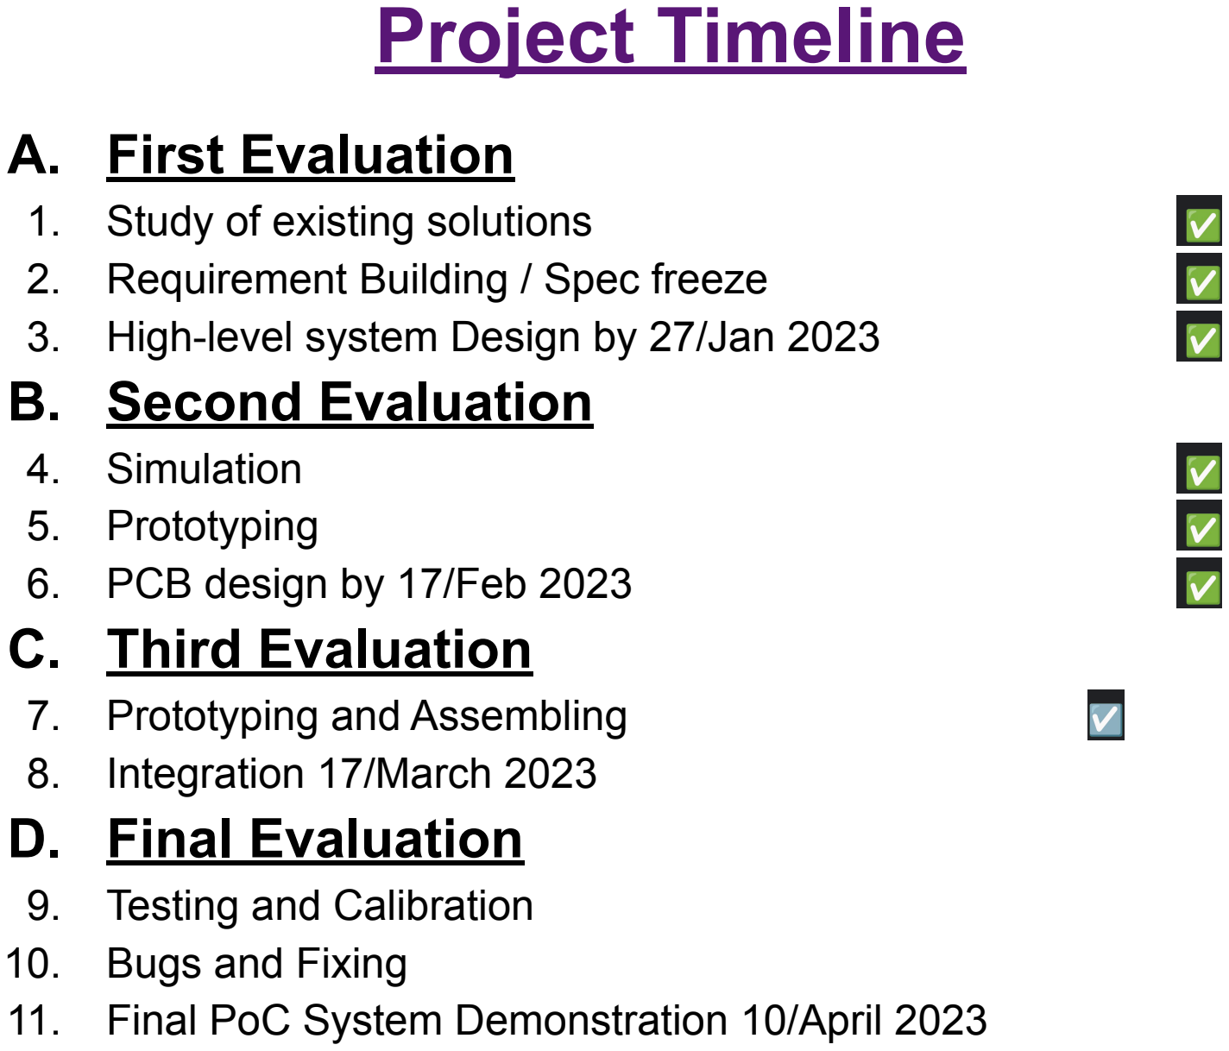
[picture p43: figure]
A. First Evaluation; 1. Study of existing solutions 2. Requirement Building / Spec freeze; B. Second Evaluation; 4. Simulation 5. Prototyping 6. PCB design by 17/Feb 2023 C. Third Evaluation; 7. Prototyping and Assembling 8. Integration 17/March 2023 D. Final Evaluation; 9. Testing and Calibration 10. Bugs and Fixing; Project Timeline

### 3. High-level system Design by 27/Jan 2023

### 11. Final PoC System Demonstration 10/April 2023

# - Voltage Range: 0-600V - Impedance: 10MΩ - Bandwidth: DC-5MHz - Common Mode Rejection Ratio (CMRR): > 65dB - Signal Noise Ratio (SNR): > 65dB - Isolation Voltage Rating: 1000V - Input Connector: Banana jack type - Output Connector: BNC - Operating Temperature: 10°C to 50°C - Power Source: External

### IITDH

### 27-Jan-23

# Wish specifications:

# System Block diagram

### IITDH

### 27-Jan-23

# Circuit Schematic

## Input attenuator

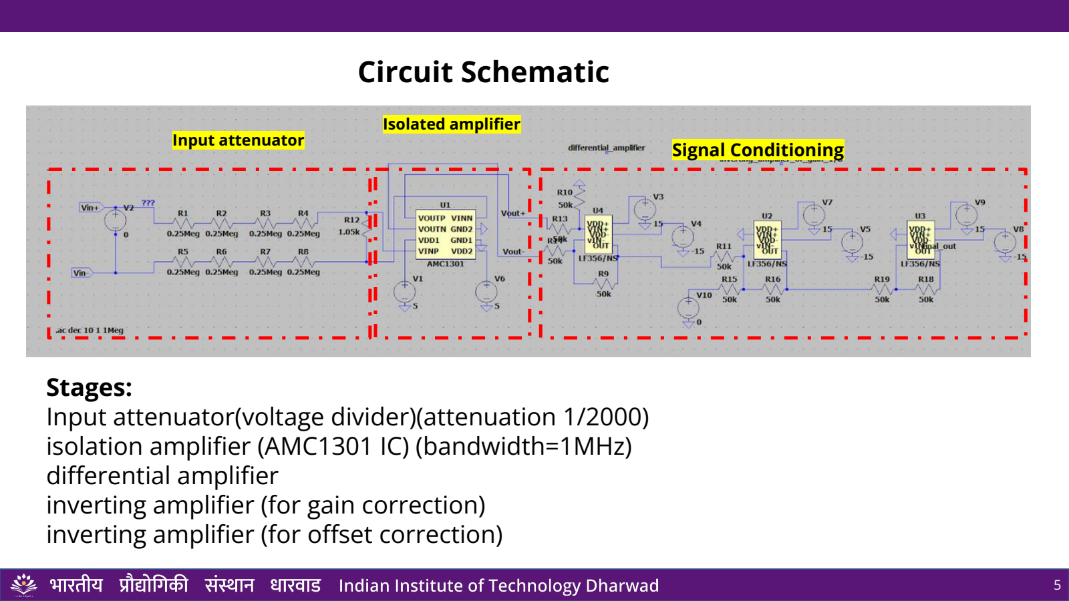
[picture p44: page 5]

# Stages:

# Input attenuator(voltage divider)(attenuation 1/2000) isolation amplifier (AMC1301 IC) (bandwidth=1MHz) differential amplifier inverting amplifier (for gain correction) inverting amplifier (for offset correction)

## Isolated amplifier

## Signal Conditioning

# Input Attenuator Stage

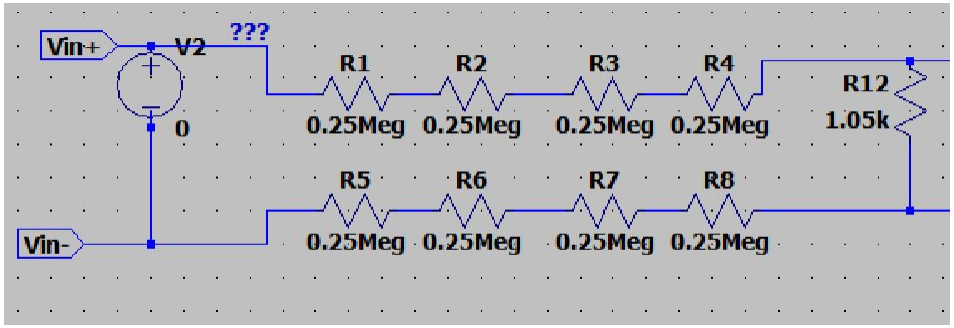
[picture p45: figure]

# Attenuation: 1/2000

# High voltage Input

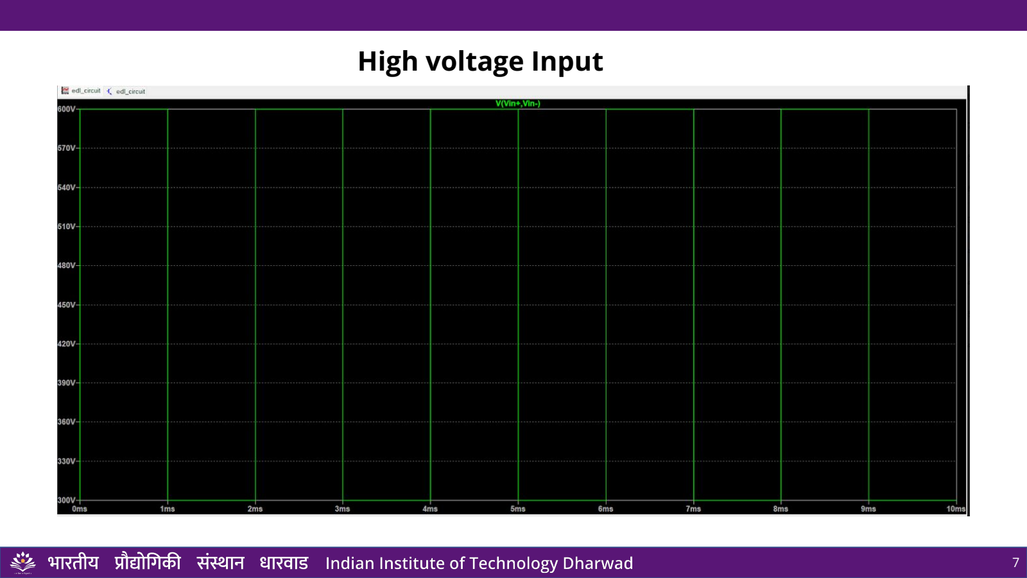
[picture p46: page 7]

# Output after Attenuator

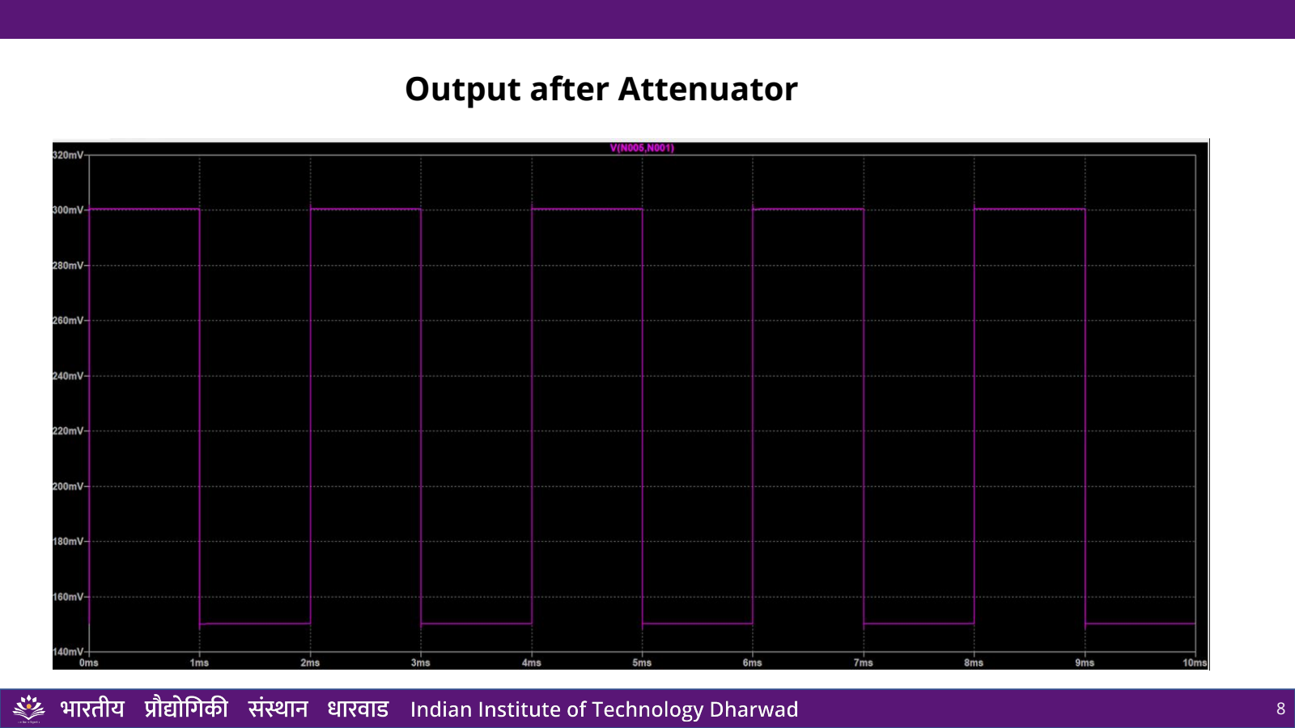
[picture p47: page 8]

# Isolated Amplifier Stage AMC1301


# Bandwidth: 1MHz gain: 8 Vdd: -0.3 to 7V


# Input voltage range : 330mV (calculated by simulations)

- Specs
GBWP | —1000 kHz
CMRR | -— 92 dB

## Operating Temperature —(-40 to 125 c)

VDD | — (–0.3 to 7) V
Input Voltage Range | — (GND1 – 6) to (VDD+ 0.5)

# Input and Output of Isolation amplifier

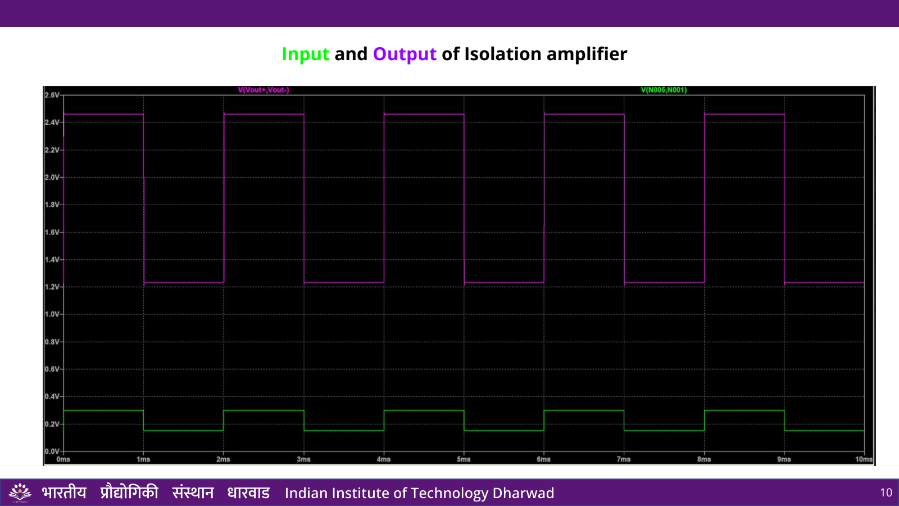
[picture p48: page 10]

# AC analysis for Sinusoidal

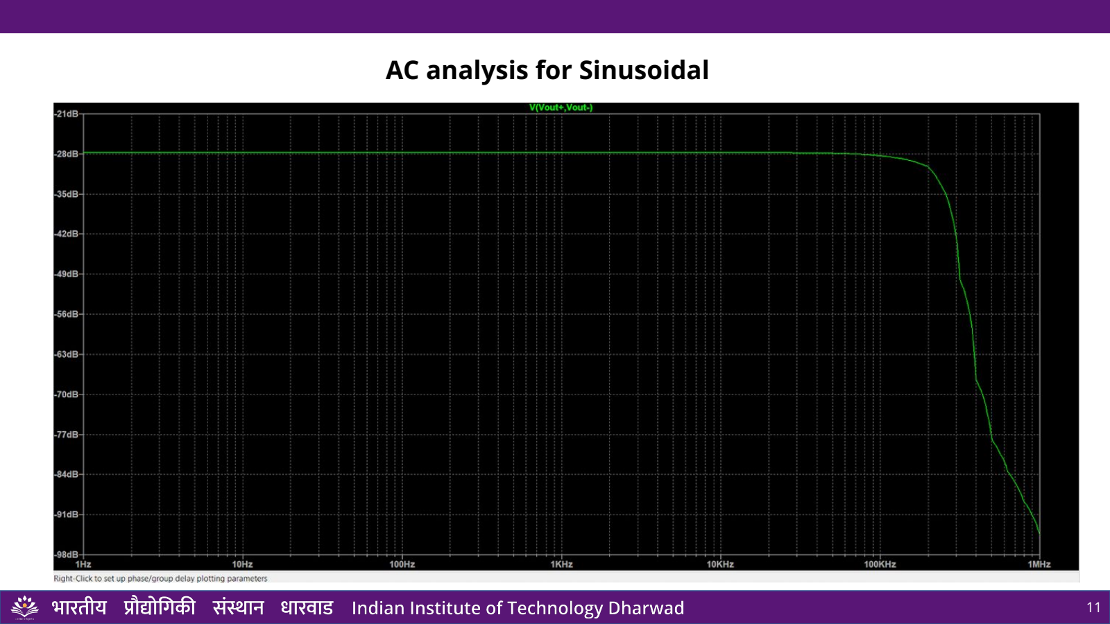
[picture p49: page 11]

# Signal Conditioning

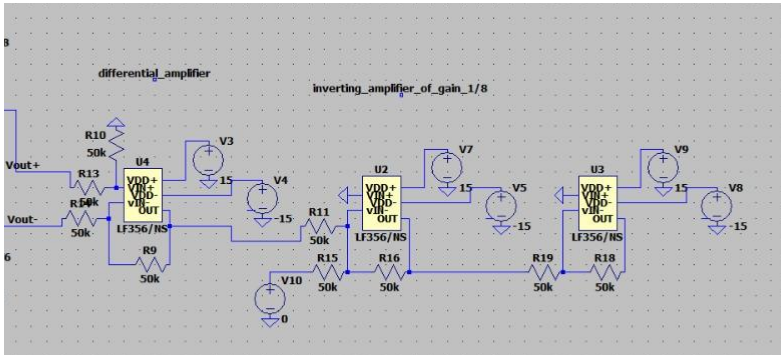
[picture p50: figure]

## IC (LF356) Differential amplifier : making output

## single ended

## Inverting amplifier : used for trimming of

## gain and offset correction

# Output after differential amplifier vs output after Isolated amplifier

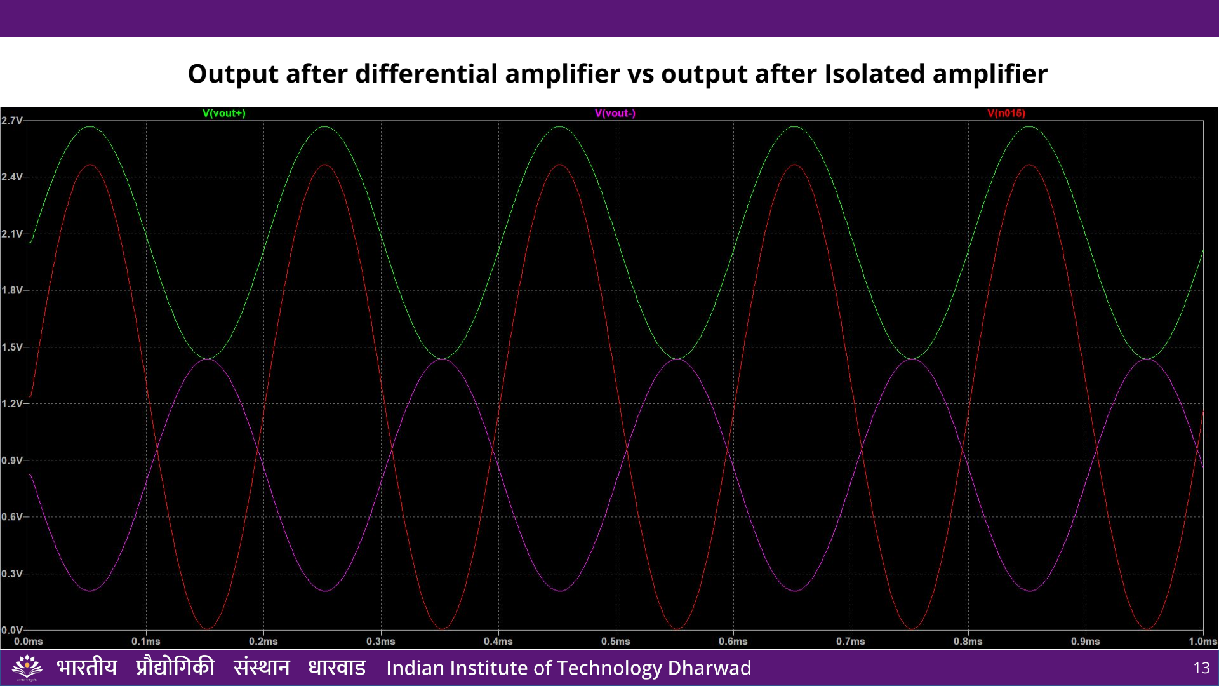
[picture p51: page 13]

Frequency (Hz) | Gain (dB) | Trimming Values (Ohm)
1-1000 | -48.14 | 51k (+75)
1000-10k | -48.14 | 51k (+75 to +107)
10k-50k | -48.15 - -48.71 | 51k(+107 to 900)
50k-63k | -48.15 - -48.71 | 52k (+403)
63k-80k | -48.15 - -48.71 | 53k (+203)
80k-100k | -48.15 - -48.71 | 54k (+544)
100k-126k | -49 | 56k (+777)
126k -158k | -49 | 60k (+654)
158k- 200k | -50 | 68k (+300)
200k-250k | -50 to -54 | 1M (+9k)
250k-500k | -54 to -90 | 6M (+57k to +542k)
500k-1M | -98 to -114 | 31M (+494k to 323k)

# Trimming Values Required for gain and offset correction

# PCB schematic diagram

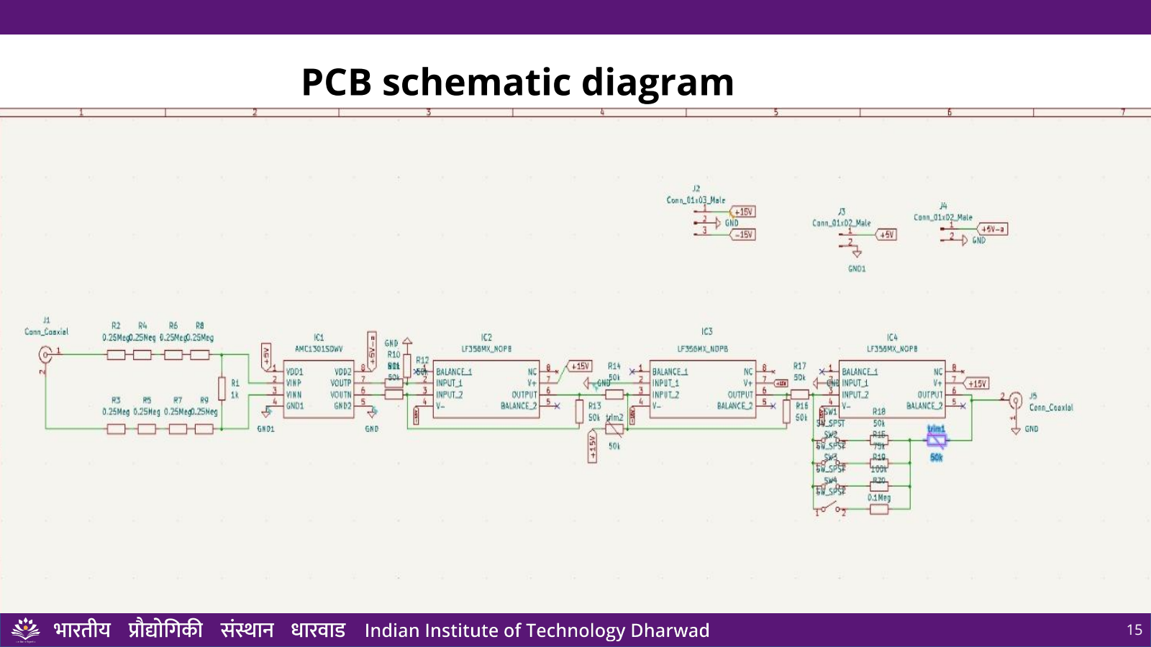
[picture p52: page 15]

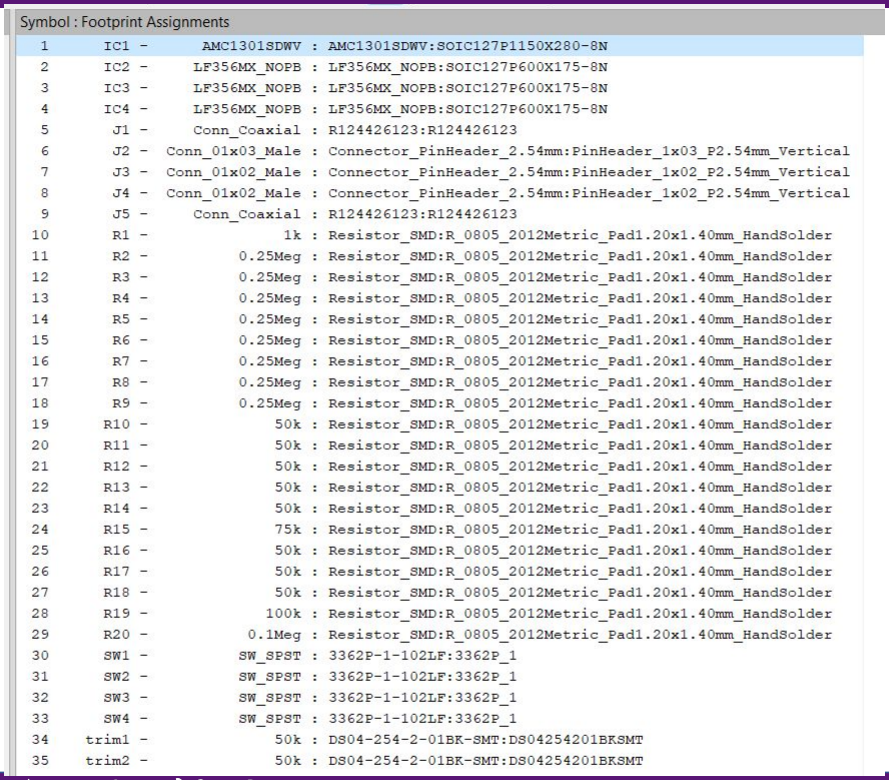
[picture p53: figure]

# Footprints used in PCB Design

# PCB Design

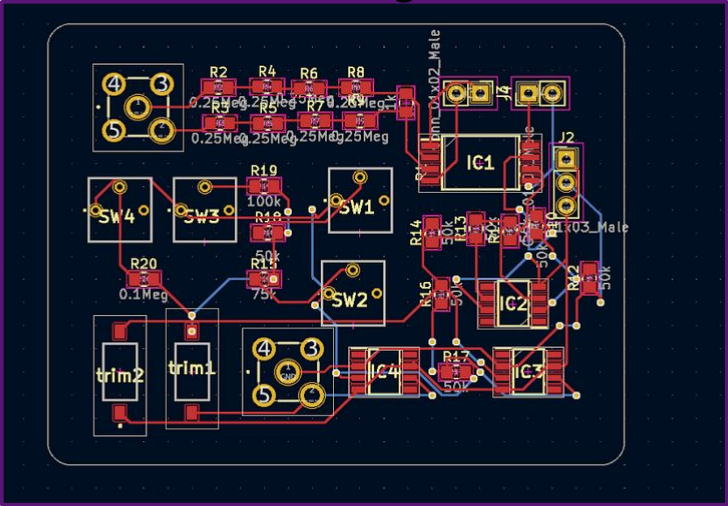
[picture p54: figure]

# 3D model of PCB Design

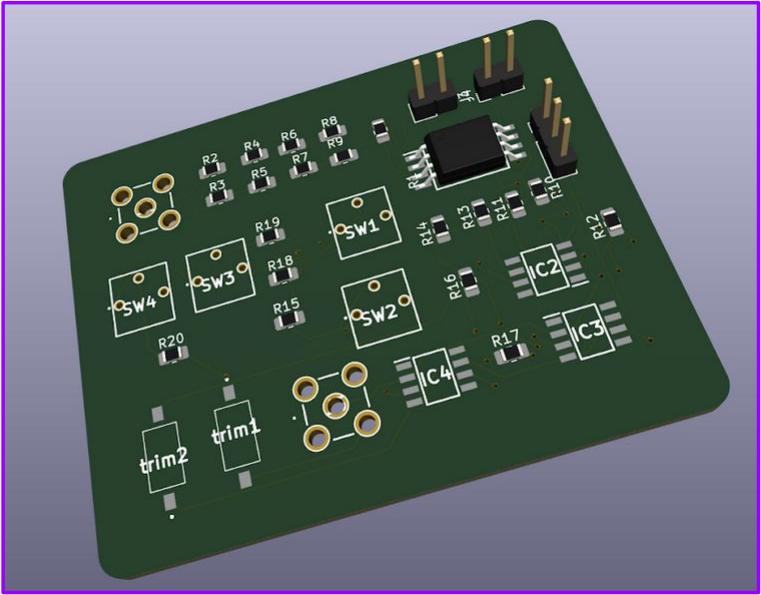
[picture p55: figure]

# Third Evaluation

## Prototyping and Assembling Integration 17/March 2023

# Future Work
