sprabha5/High-Voltage-Isolated-Differential-Probe/Lab_Presentations/third_presentation.pdf

# High Voltage Isolated Differential Probe

## Team Members:

Shashi prabha | 200020043
Mouli Venkata Prakash 200020027
Devi Prasad | 200020022

## Project Supervisor

Prof. Dr.Abhijit Kshirsagar
Dept. of Electrical Engineering IIT Dharwad

# EE314: EDL Project Evaluation 3

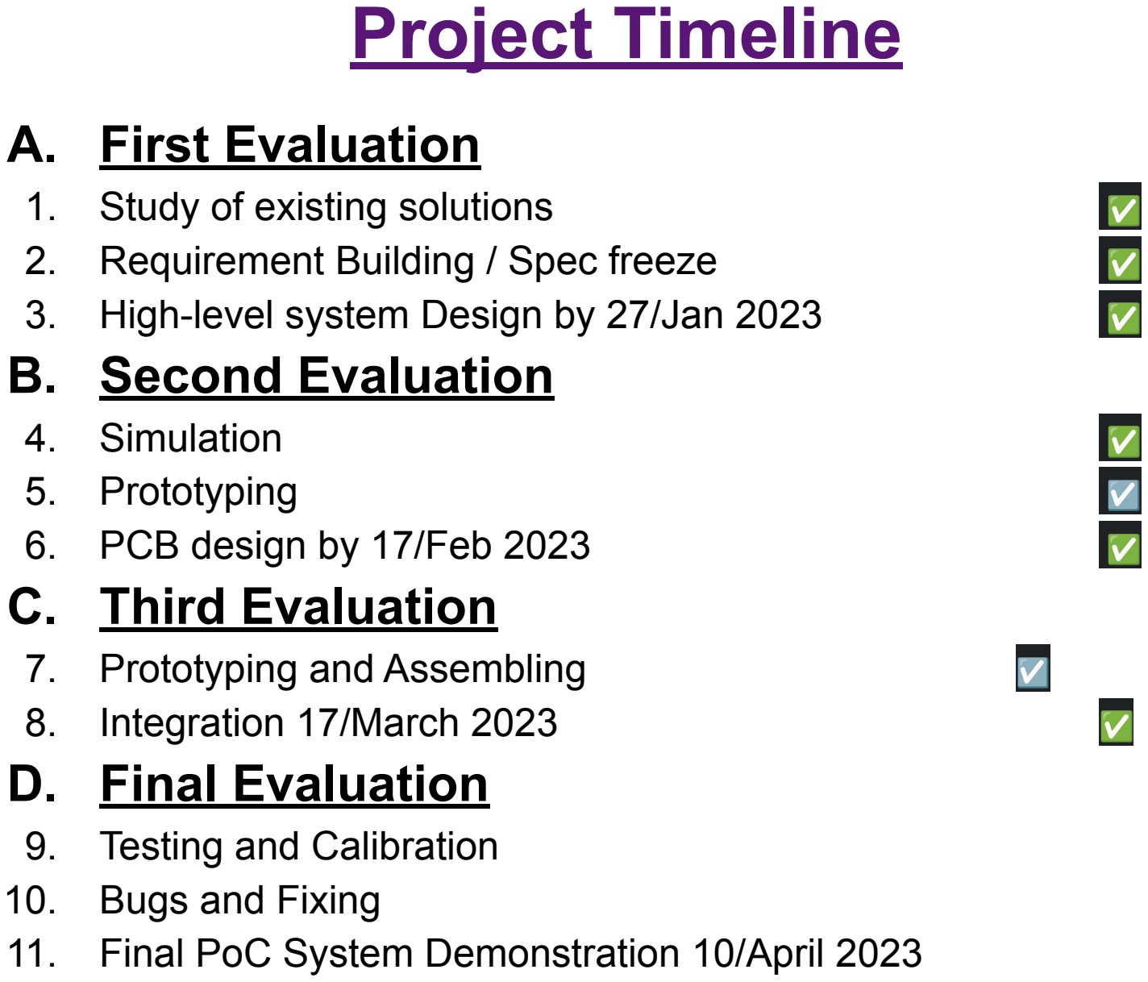
[picture p56: figure]
A. First Evaluation; 1. Study of existing solutions 2. Requirement Building / Spec freeze; B. Second Evaluation; 4. Simulation 5. Prototyping 6. PCB design by 17/Feb 2023 C. Third Evaluation; 7. Prototyping and Assembling 8. Integration 17/March 2023 D. Final Evaluation; 9. Testing and Calibration 10. Bugs and Fixing; Project Timeline

3. High-level system Design by 27/Jan 2023
11. Final PoC System Demonstration 10/April 2023

# - Voltage Range: 0-600V - Impedance: 10MΩ - Bandwidth: DC-5MHz - Common Mode Rejection Ratio (CMRR): > 65dB - Signal Noise Ratio (SNR): > 65dB - Isolation Voltage Rating: 1000V - Input Connector: Banana jack type - Output Connector: BNC - Operating Temperature: 10°C to 50°C - Power Source: External

IITDH

27-Jan-23

# Wish specifications:

# System Block diagram

IITDH

27-Jan-23

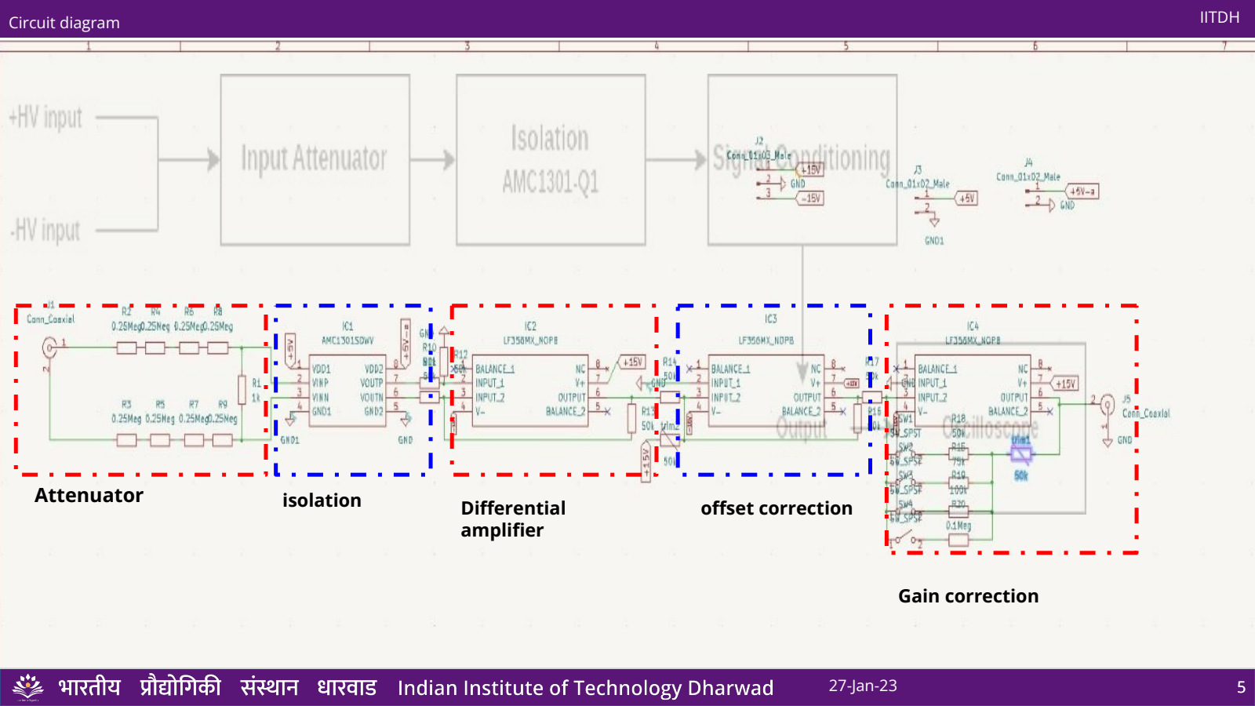
[picture p57: page 5]

Circuit diagram | IITDH

27-Jan-23

Attenuator | isolation | Differential amplifier
offset correction

Gain correction

# Test plan

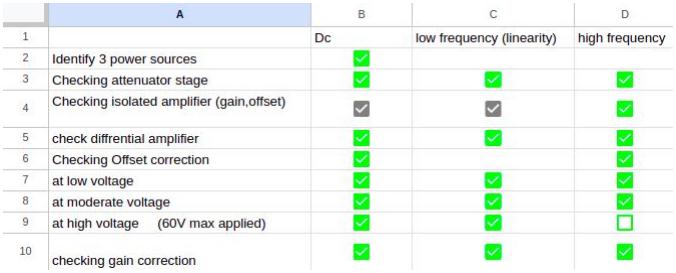
[picture p58: figure]

Checking attenuator stage:
since at the starting stage we can’t deal with 600V so we start with
1) One stage attenuator
2) two stage attenuator
3)three stage attenuator
4) four stage attenuator

# At an input of 480V pp

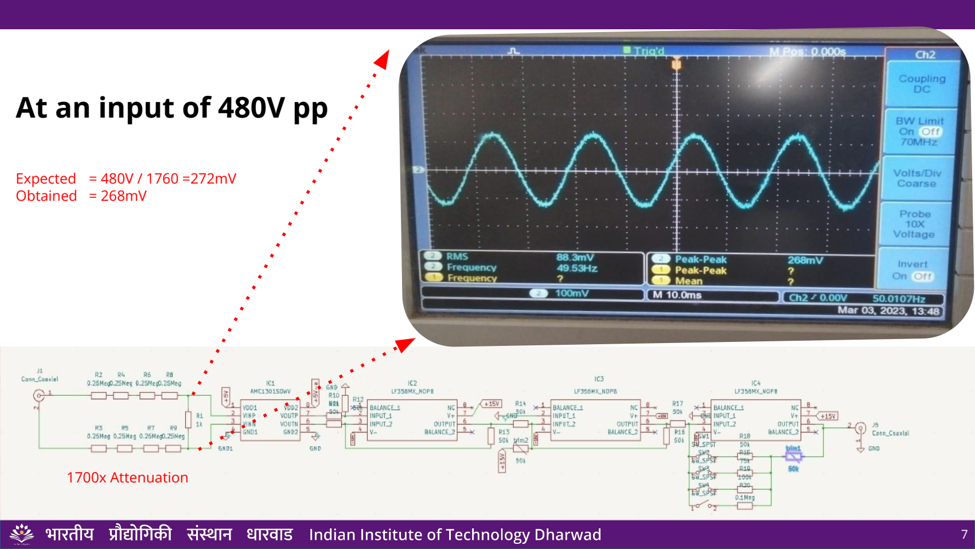
[picture p59: page 7]

1700x Attenuation

Expected = 480V / 1760 =272mV Obtained = 268mV

Attenuator | 60V DC four stage attenuator

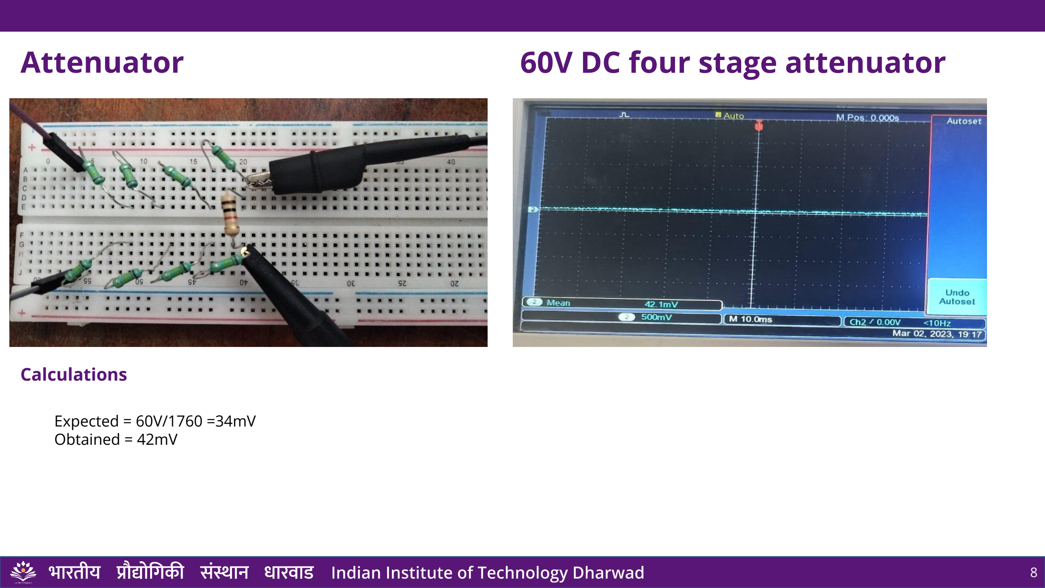
[picture p60: page 8]

### Calculations

Expected = 60V/1760 =34mV
Obtained = 42mV

## 60V DC one stage attenuator

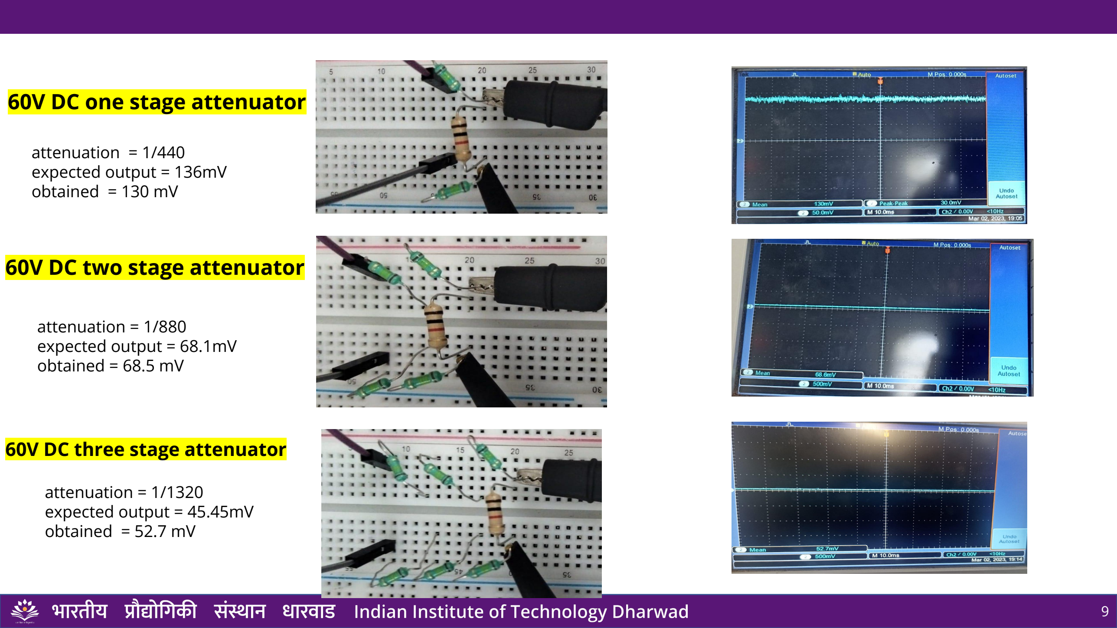
[picture p61: page 9]

## 60V DC two stage attenuator

### 60V DC three stage attenuator

attenuation = 1/440
expected output = 136mV
obtained = 130 mV

attenuation = 1/880
expected output = 68.1mV
obtained = 68.5 mV

attenuation = 1/1320
expected output = 45.45mV
obtained = 52.7 mV

# At an input of 200 mv pp to isolation amplifier at

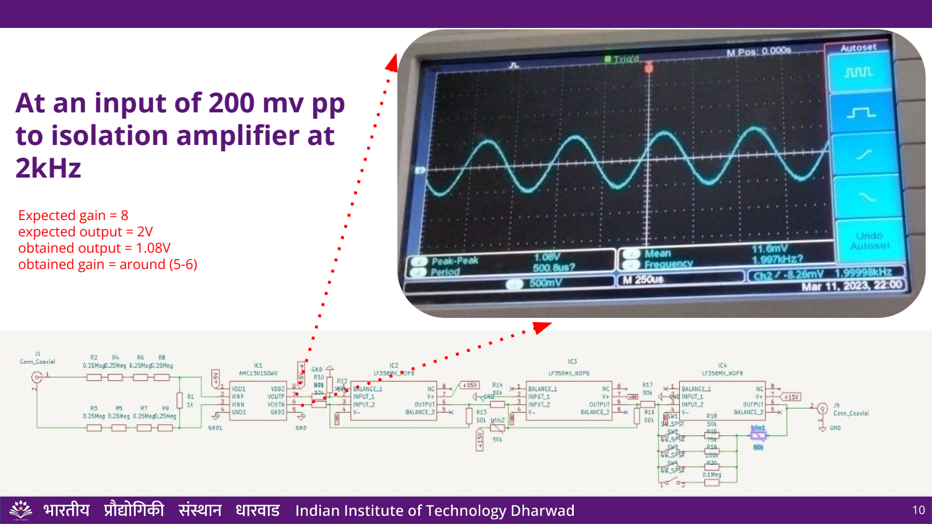
[picture p62: page 10]

# 2kHz

Expected gain = 8
expected output = 2V
obtained output = 1.08V
obtained gain = around (5-6)

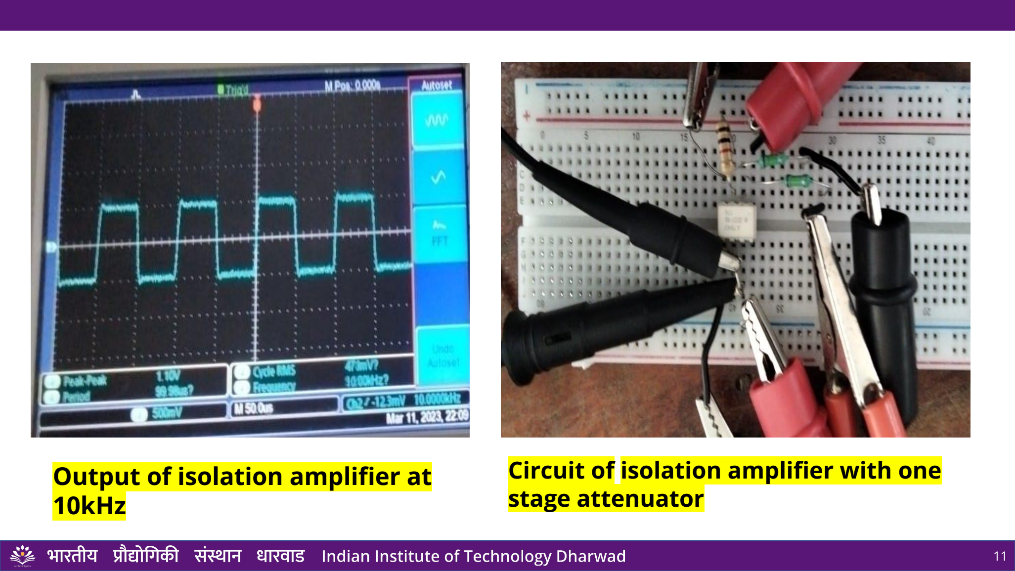
[picture p63: page 11]

# Output of isolation amplifier at 10kHz

## Circuit of isolation amplifier with one stage attenuator

# POWER SOURCE for isolation amplifier

# 1) Input side and output side with RPS 2) Both side RPS through isolation transformer 3) Input side with battery and output side with RPS 4) Input side with RPS and output side with battery 5) used LC filter for cancellation of noise 6) Input side and output side with battery

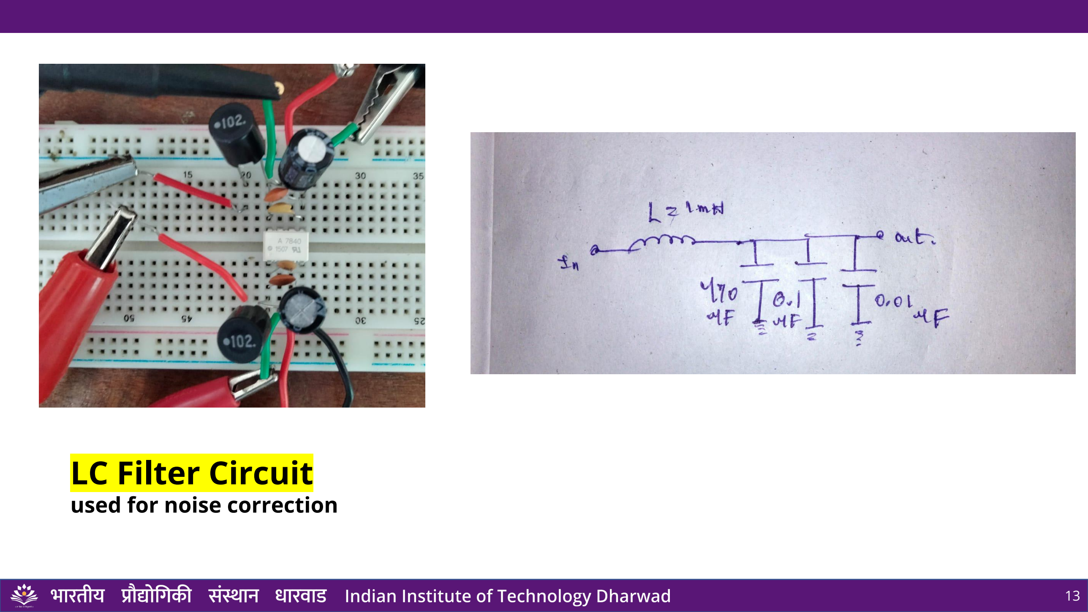
[picture p64: page 13]

# LC Filter Circuit

## used for noise correction

# Differential Amplifier

## At an input of 5V pp

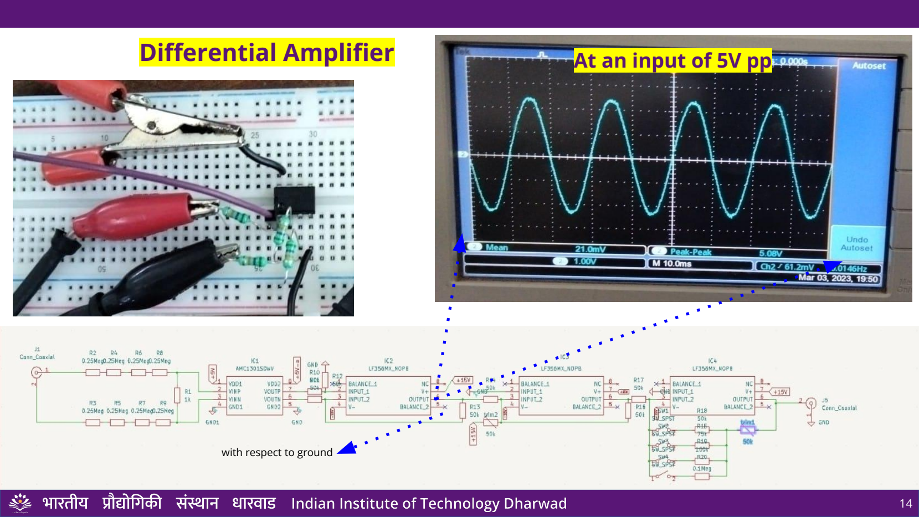
[picture p65: page 14]

with respect to ground

Summing amplifier(offset correction) | At an input of 10V pp

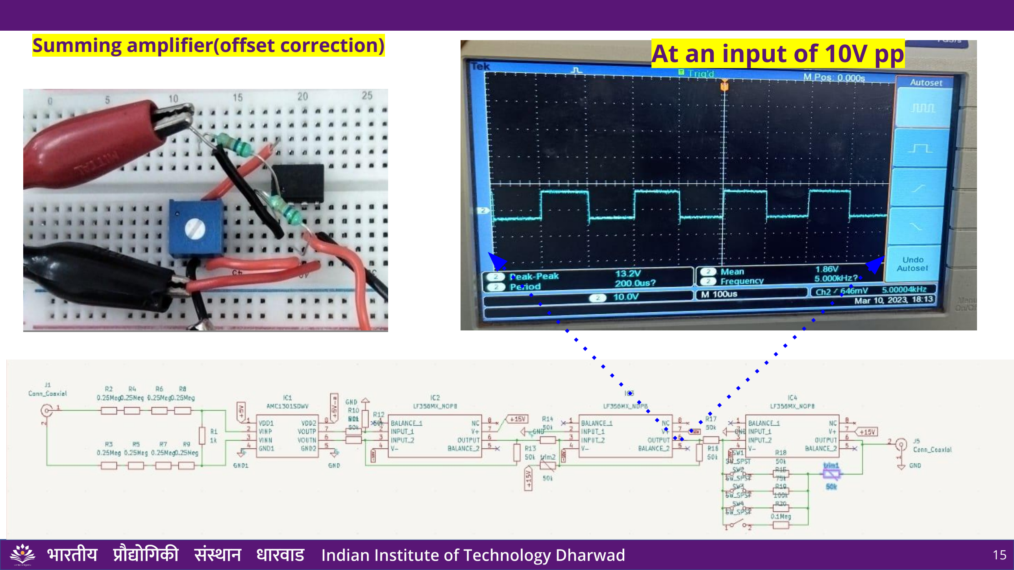
[picture p66: page 15]

## Inverting amplifier (Gain Correction)

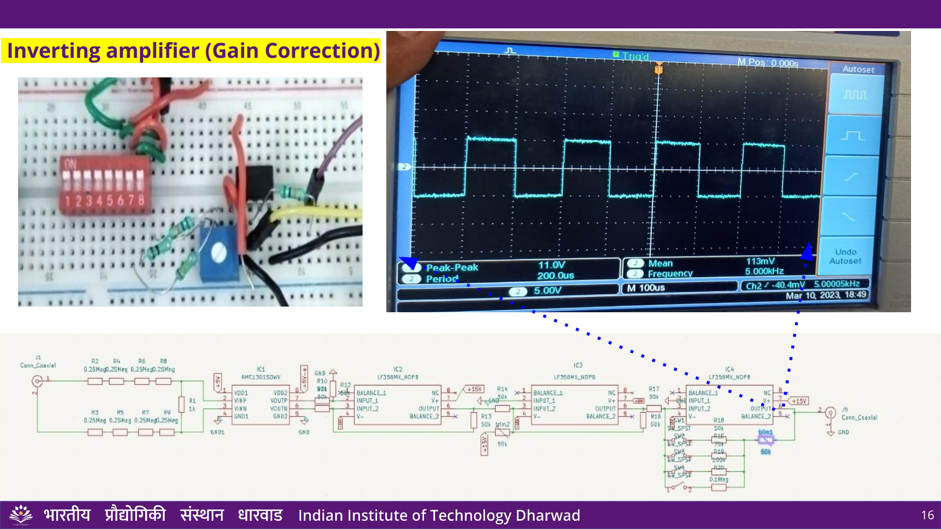
[picture p67: page 16]

# 3D PCB DESIGN

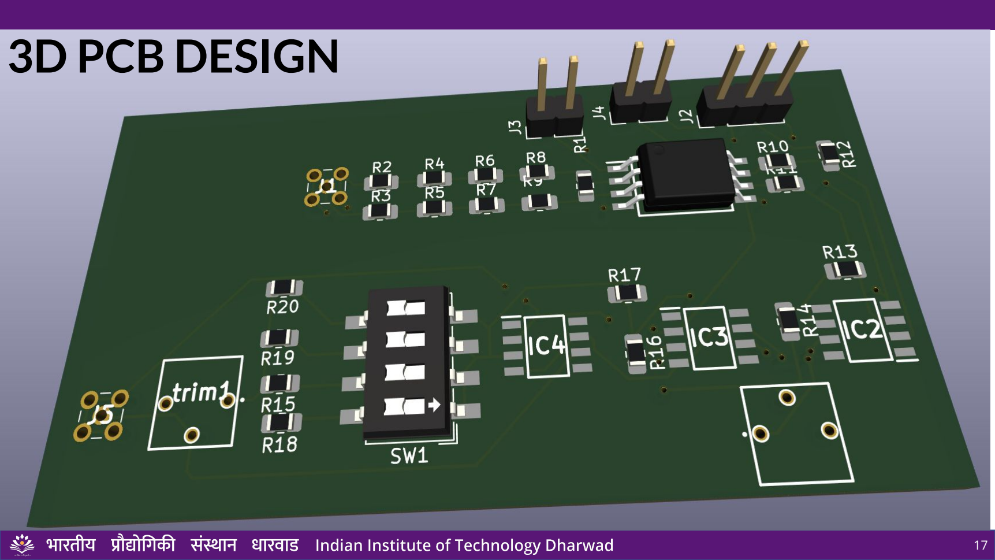
[picture p68: page 17]

# Final Evaluation

## 1. Testing and Calibration 2. Bugs and Fixing 3. Final PoC System Demonstration 10/April

2023

# Future work / path to completion

# We will show our working design for 600V

DC which will display voltage value in DSO.

# Final demo plan
