sprabha5/High-Voltage-Isolated-Differential-Probe/Publication/Conference_presentation.pdf

## Ultra Low-Cost High-Voltage Isolated Differential Probe for Teaching and Training

Mouli Venkata Prakash, Shashi Prabha, Devi prasad,

### Daniel DSA, Little Pradhan & Abhijit kshirsagar

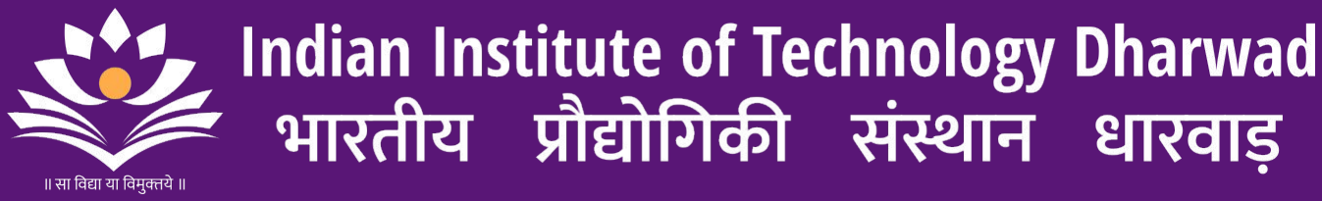
[picture p69: figure]

19 Dec. 2023,
Thiruvananthapuram

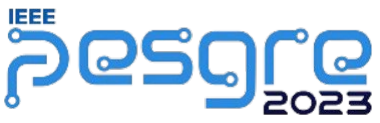
[picture p70: figure]

## Outline:

●Introduction
●Probe features
●Proposed High Voltage Probe with Isolation ●Stages of Designed Probe
●Noise Blocking for isolation probe
●Power supply
●Hardware Results
●Layout and final product

## Introduction:

- Need for High-voltage Isolated Measurement:
- Education, training, Research (beyond just power engineering)
- Challenge:
- Costly, Specialized Equipment for voltages >400V
- Lack of galvanic isolation in oscilloscopes.
- Existing solutions:
- Expensive differential probes, lacking galvanic isolated channels in oscilloscopes.
- Target Spec: Affordable, portable, isolated high-voltage differential probe (up to 600V, 350 KHz bandwidth) designed for labs in Power Electronics, Electric Machines and Drives, Renewable Energy, etc.

# Desirable Features:

•Removable lithium-ion battery, direct oscilloscope interface,

### gain/offset correction for periodic calibration

- Target User: Cost-sensitive applications in universities, makerspaces,

### startups, and industries requiring effective yet affordable high-voltage

measurement solutions.

## Proposed High Voltage Probe with Isolation:

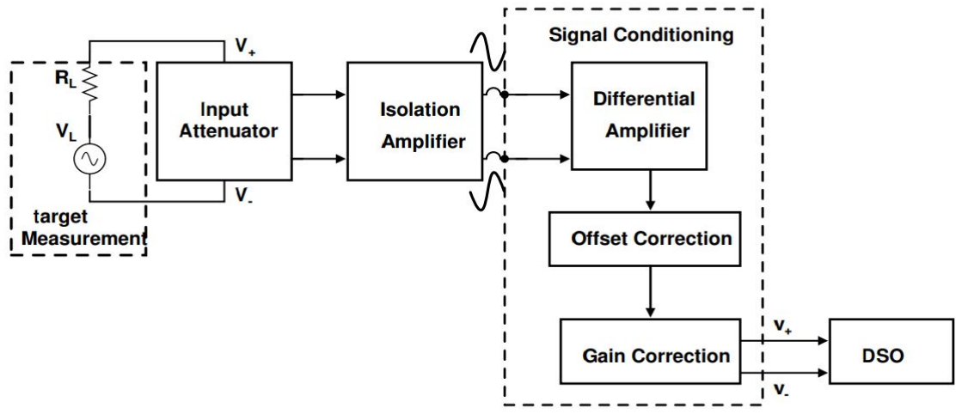
[picture p71: figure]

- Isolation Amplifier Limitation: Input range constrained between +300mV and -300mV, necessitating attenuation of high input voltages.
- Attenuator Circuit: Comprises eight 250kΩ resistors in series and one 1kΩ resistor to reduce the high input voltage to the isolation amplifier's acceptable range.
- Input range of HV Probe = 2000 × (−300mV, +300mV),
- where (-300mV, +300mV) represents the isolation amplifier input voltage range.
- Resulting Measurement Range: The proposed HV probe can measure input voltage signals ranging from -600V to +600V.

## Attenuator:

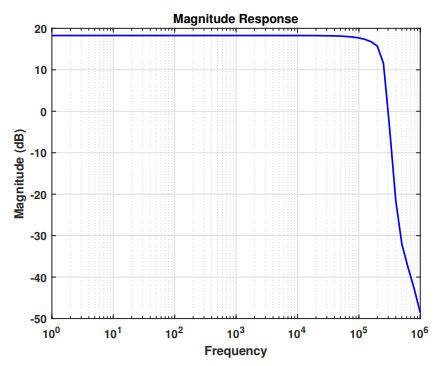
[picture p72: figure]

- Isolation Amplifier: Utilizes the Texas Instruments AMC1301, requiring a +5V power supply generated through the LM7805 regulator.
- Amplifier Gain: LTspice simulation indicates an amplifier gain of 18.6 dB, translating to a voltage gain of 8 up to 100 KHz.
- LC Low-Pass Filter Employed in the power supply to eliminate unwanted noise signals before reaching the isolation amplifier.

## Isolation Amplifier:

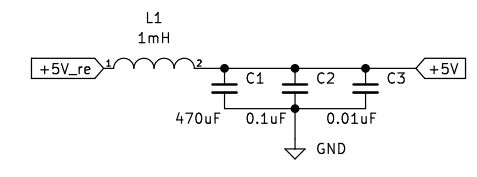
[picture p73: figure]

- Filter Configuration: Designed for DC signal passage by setting a low cutoff frequency.
- Cutoff Frequency Calculation: Cutoff frequency derived from combined capacitance (C = 470.1µF) and inductor value (L = 1mH) using the formula:

This LC low-pass filter setup aims to allow only DC signals by ensuring a very low cutoff frequency.

## Power Supply Decoupling For Isolation Amplifier:

## POWER SUPPLY:

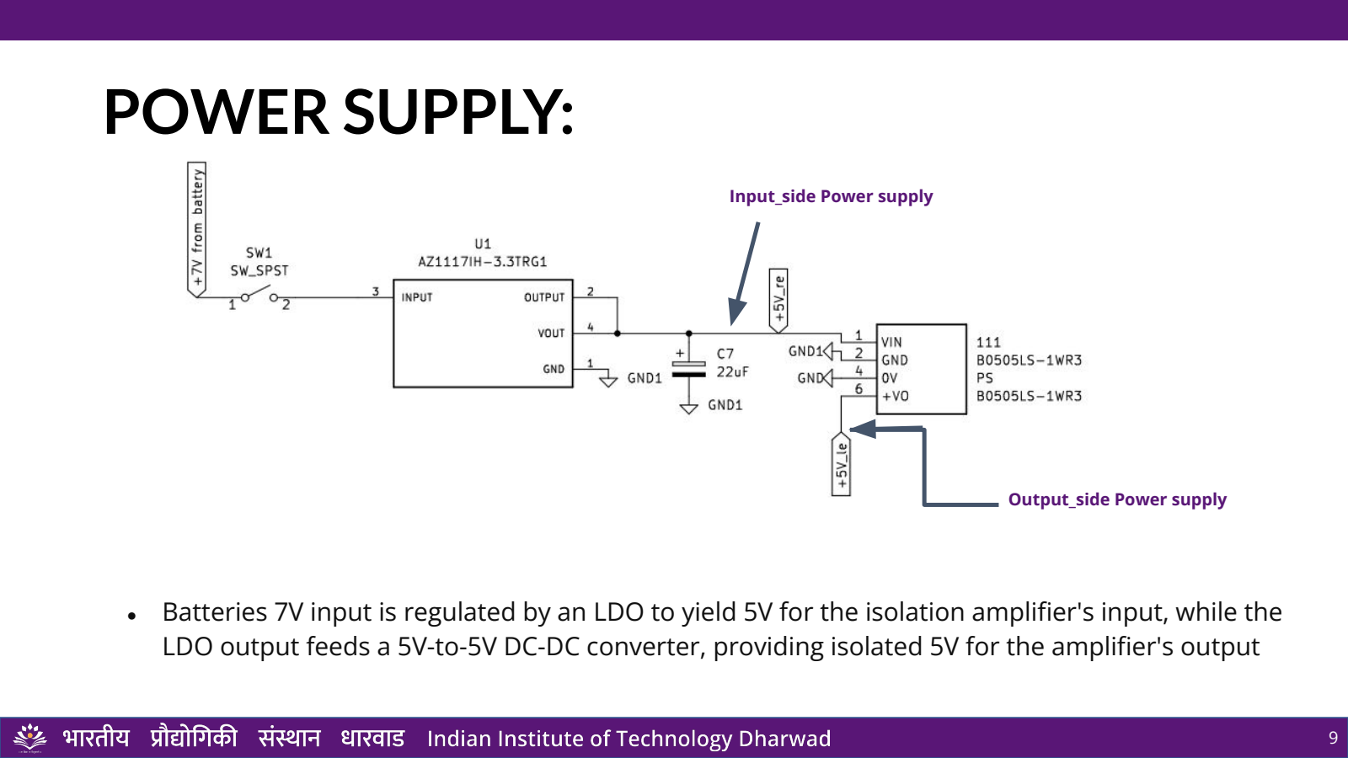
[picture p74: page 9]

- Batteries 7V input is regulated by an LDO to yield 5V for the isolation amplifier's input, while the LDO output feeds a 5V-to-5V DC-DC converter, providing isolated 5V for the amplifier's output

Input_side Power supply

Output_side Power supply

- Converts the differential input into a ground-referenced signal, enabling analysis via an oscilloscope.
- LF356 Op-Amp Implementation: Utilizes the LF356 integrated circuit operational amplifier (op-amp) within the differential circuit for this transformation.

### Power Supply:

## Differential Amplifier:

- DC Offset Issue: Expected output shows a DC offset at higher input voltage levels , requiring correction.
- Correction Method was Employed by a summing amplifier for fine-tuning the DC level, utilizing a trimmer for adjustment.
- +5V and -5V DC Generation Illustrated below, which is crucial for achieving the required DC level adjustment in the signal conditioning circuit.

## Offset Error:

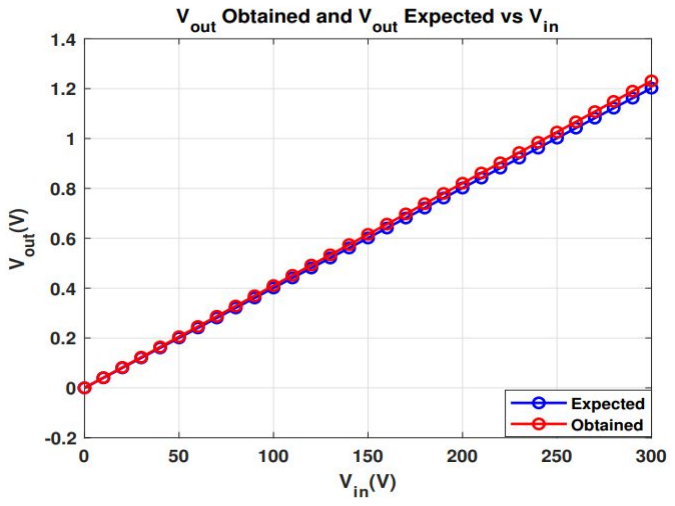
[picture p75: figure]
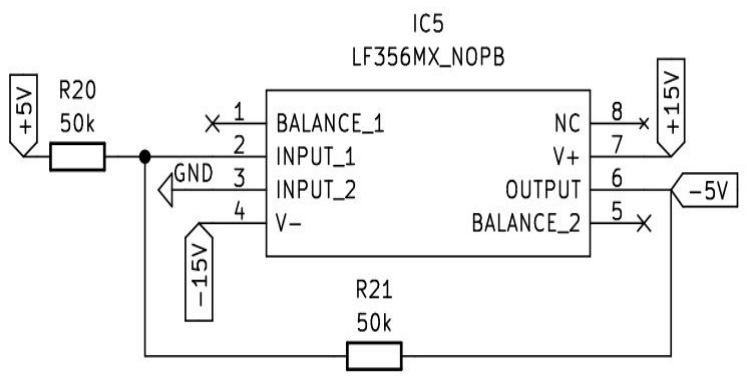
[picture p76: figure]

- Observes decreased isolation amplifier gain above 100 kHz, impacting high-frequency applications.
- Need for Gain Correction: Above 100 kHz, requires a gain correction circuit for proper signal amplification.
- Incorporated Solution was Integration of an inverting amplifier within the signal conditioning circuit. Features a trimmer for manual gain adjustment, crucial for compensating attenuations and ensuring accurate signal amplification at higher frequencies.

## Offset Error:

## Circuit Diagram :

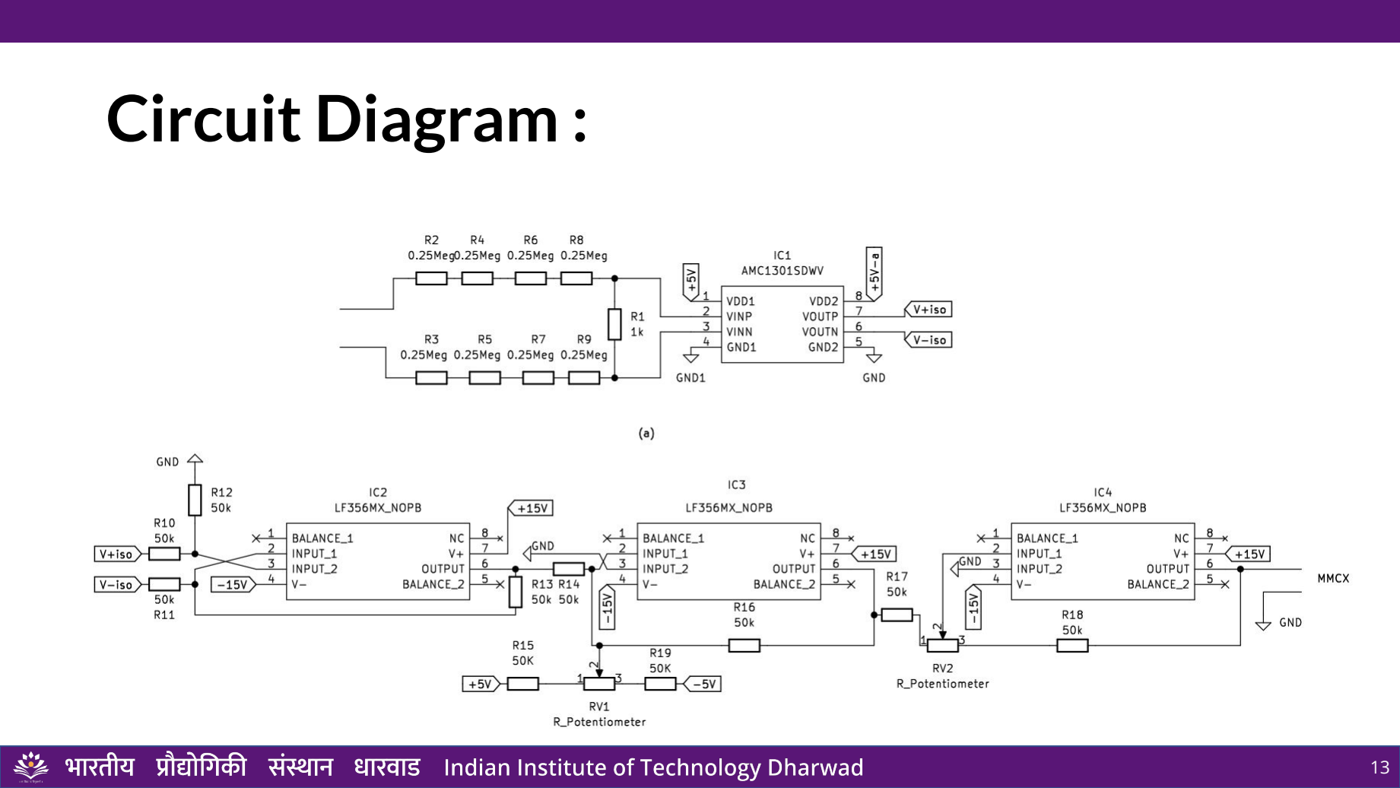
[picture p77: page 13]

## Hardware Results:

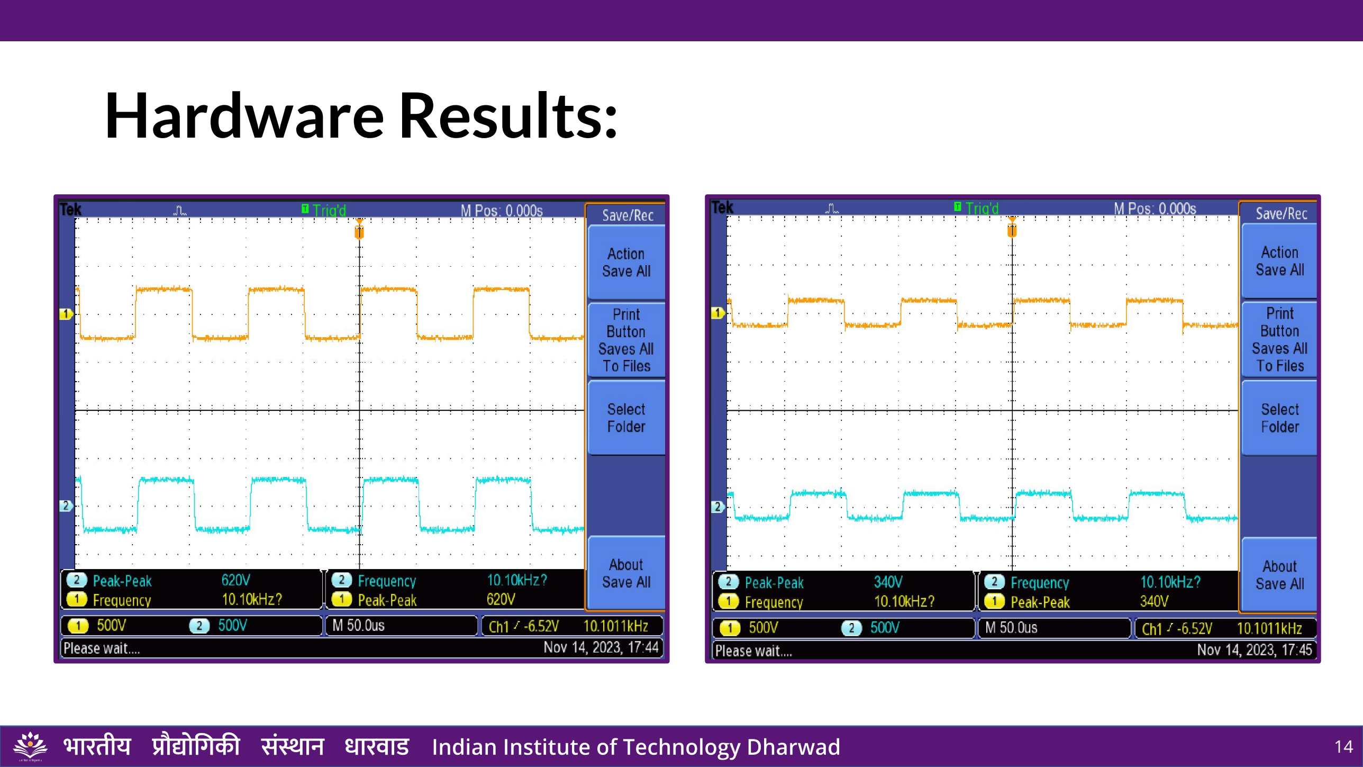
[picture p78: page 14]

## Hardware Results:

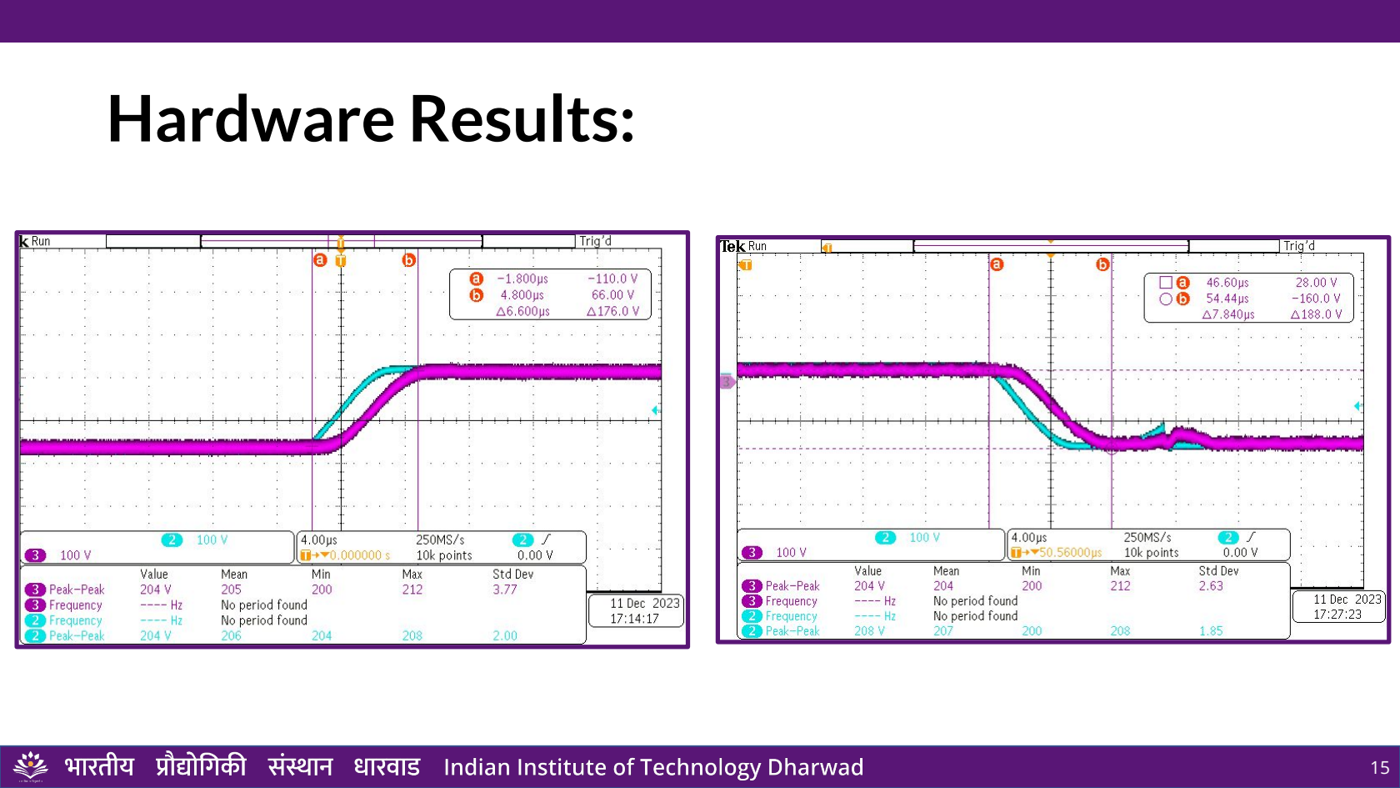
[picture p79: page 15]

## Hardware Results:

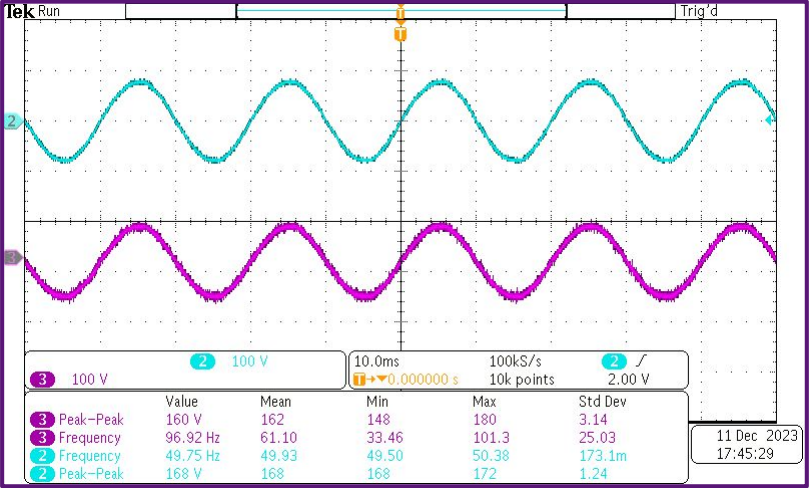
[picture p80: figure]
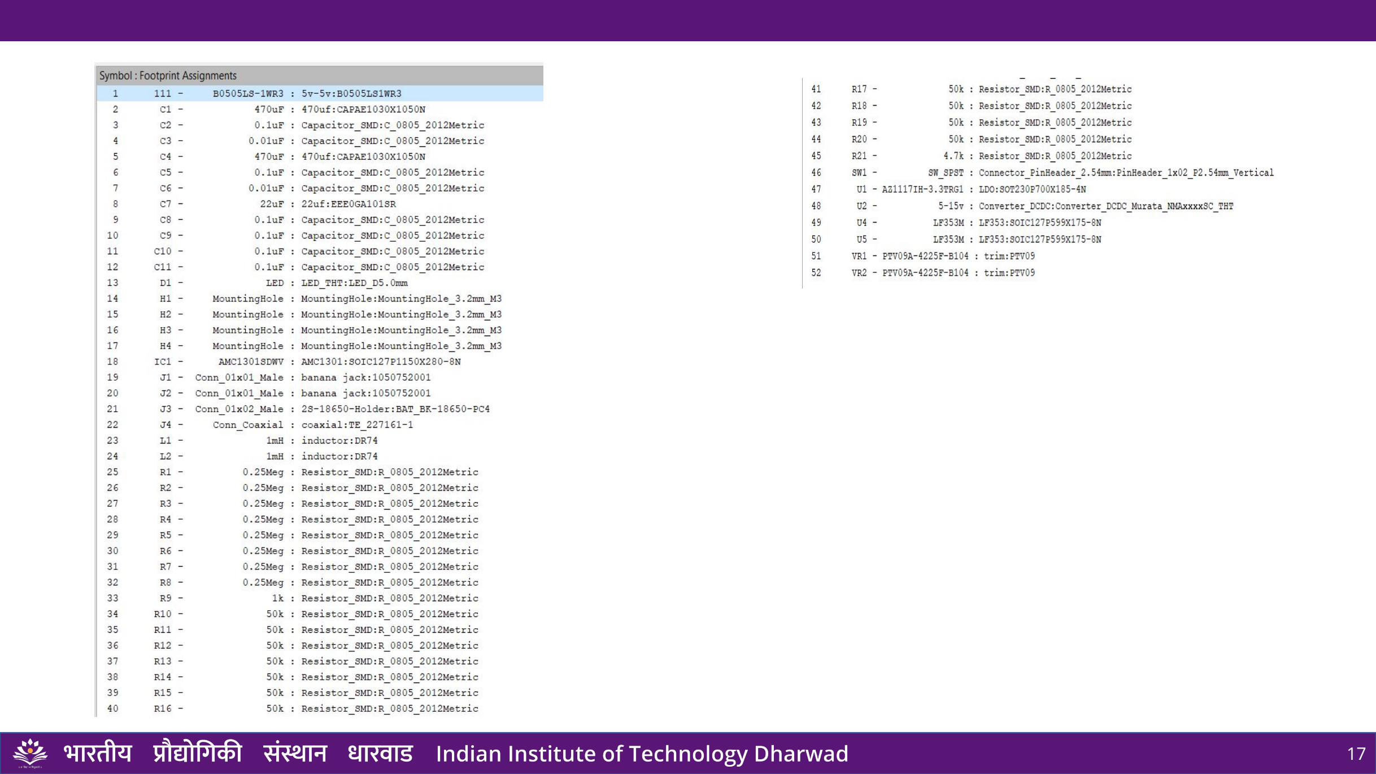
[picture p81: page 17]
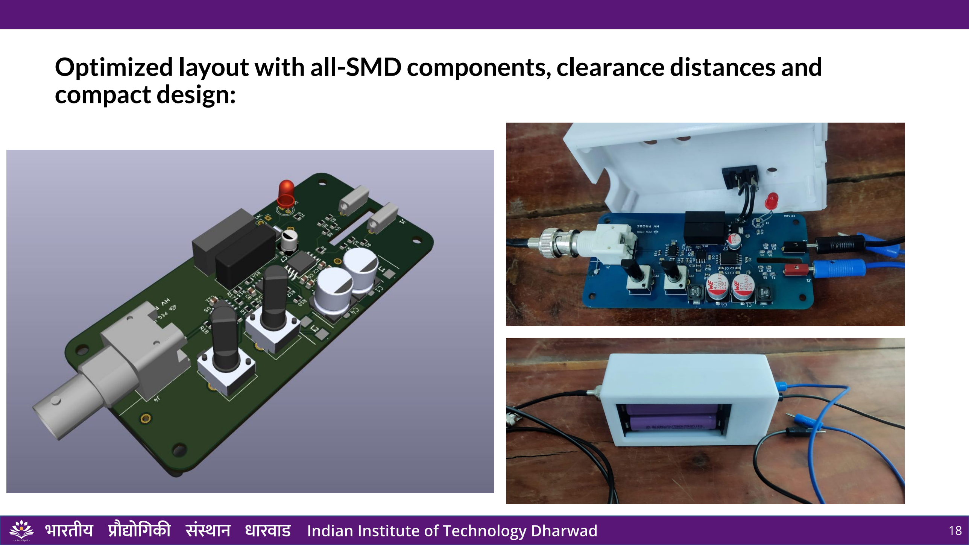
[picture p82: page 18]

Optimized layout with all-SMD components, clearance distances and compact design:

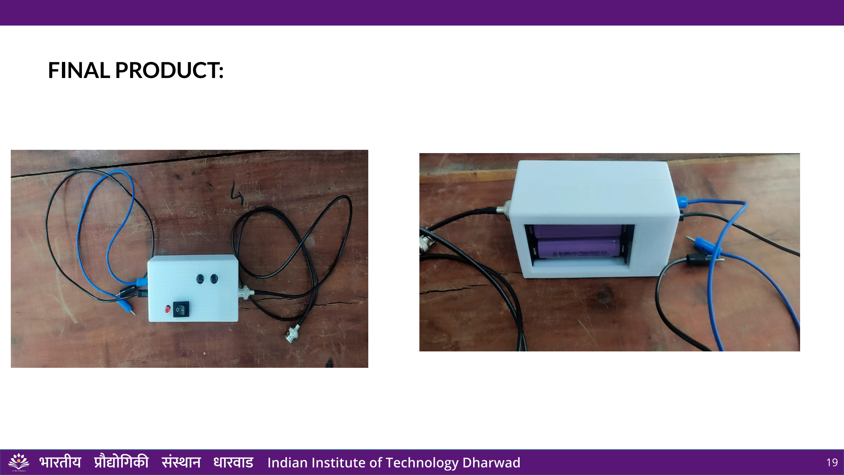
[picture p83: page 19]

FINAL PRODUCT:

# THANK YOU


## Ultra Low-Cost High-Voltage Isolated Differential Probe for Teaching and Training

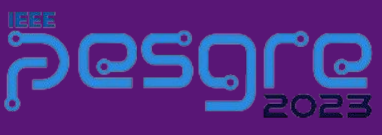
[picture p84: figure]

Authors: Mouli venkata prakash, Shashi Prabha, Devi prasad,

### Daniel, Little pradhan and Dr.Abhijit kshirsagar
