sprabha5/High-Voltage-Isolated-Differential-Probe/probe.jpg

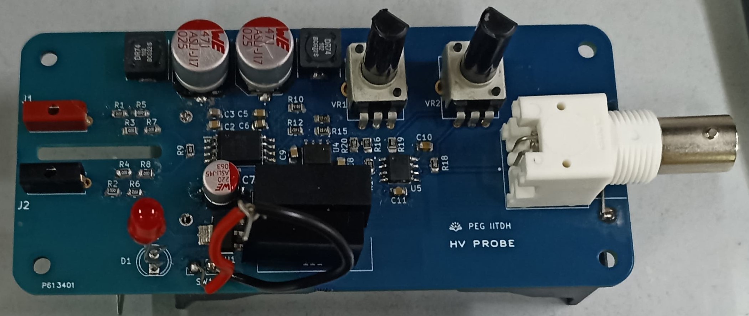
probe.jpg
