sprabha5/High-Voltage-Isolated-Differential-Probe/PCB_files/Footprints & Symbols/5v-5v/5v-5v/B0505LS-1WR3.stp

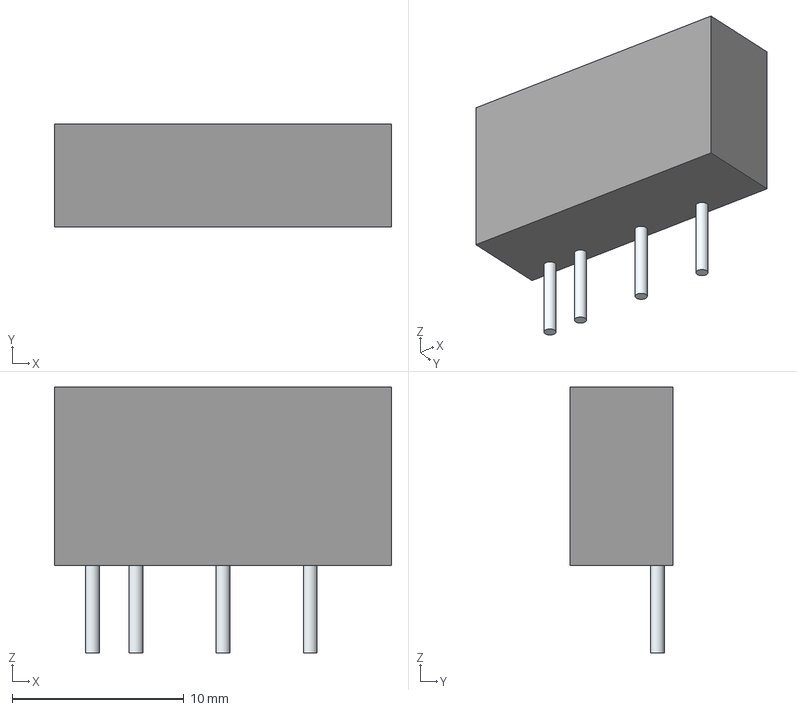
[picture p86: CAD file, 2024-03-08]
PCB_files/Footprints & Symbols/5v-5v/5v-5v/B0505LS-1WR3.stp
19.7 x 6.00 x 15.5 mm
Leads
