sprabha5/High-Voltage-Isolated-Differential-Probe/Breadboard_Simulations & Results/60V Ac ( 50Hz) attenuator.jpeg

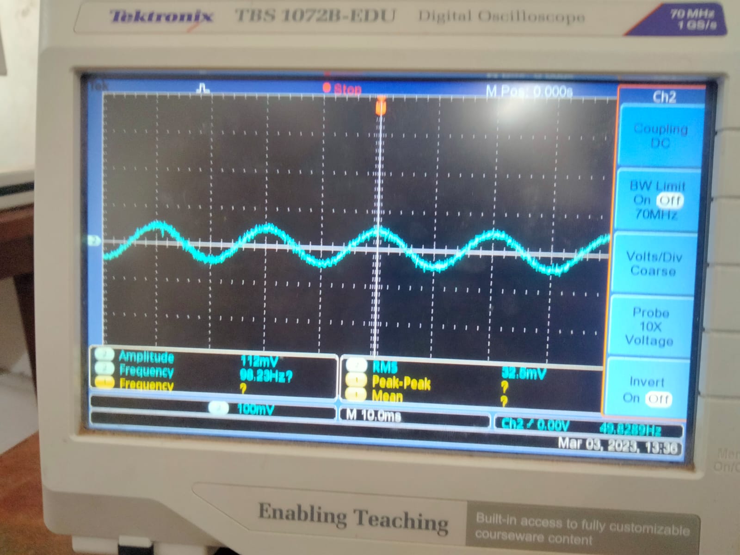
Breadboard_Simulations & Results/60V Ac ( 50Hz) attenuator.jpeg
