sprabha5/High-Voltage-Isolated-Differential-Probe/Breadboard_Simulations & Results/60V DC  isolation amplifier two stage.jpeg

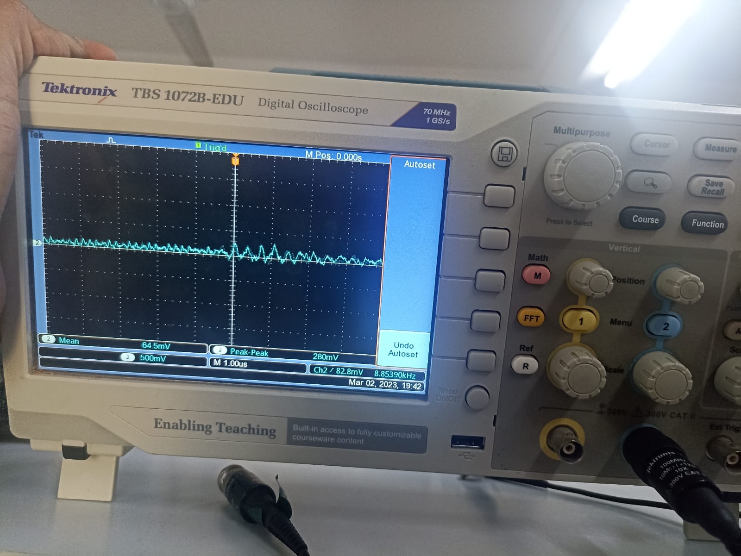
Breadboard_Simulations & Results/60V DC isolation amplifier two stage.jpeg
