sprabha5/High-Voltage-Isolated-Differential-Probe/Breadboard_Simulations & Results/60V DC three stage attenuator.jpeg

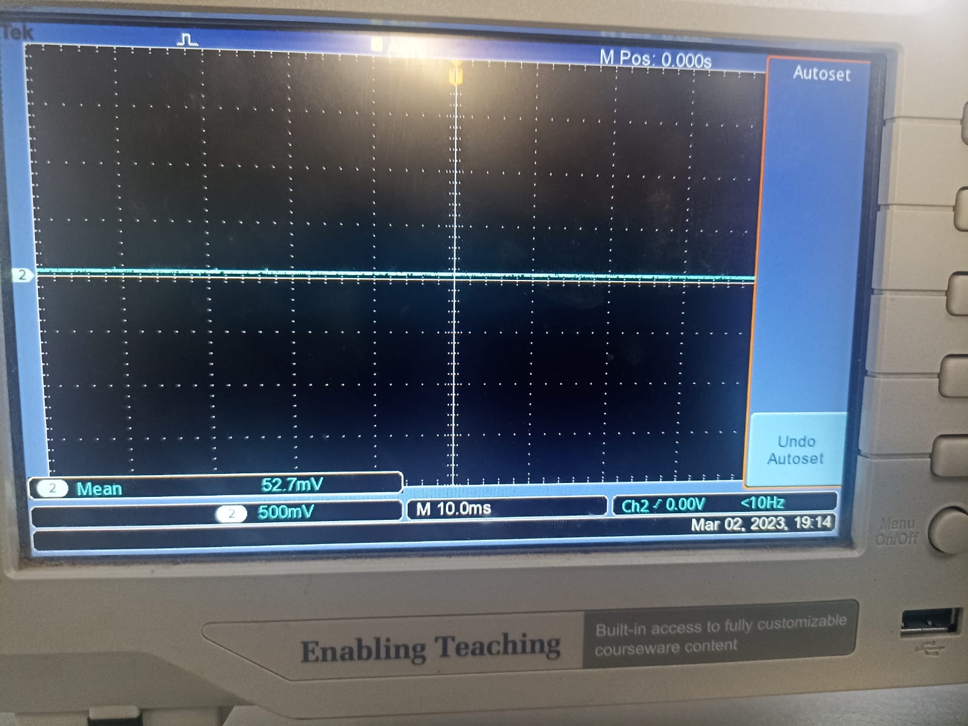
Breadboard_Simulations & Results/60V DC three stage attenuator.jpeg
