sprabha5/High-Voltage-Isolated-Differential-Probe/Breadboard_Simulations & Results/60V DC two stage attenuator.jpeg

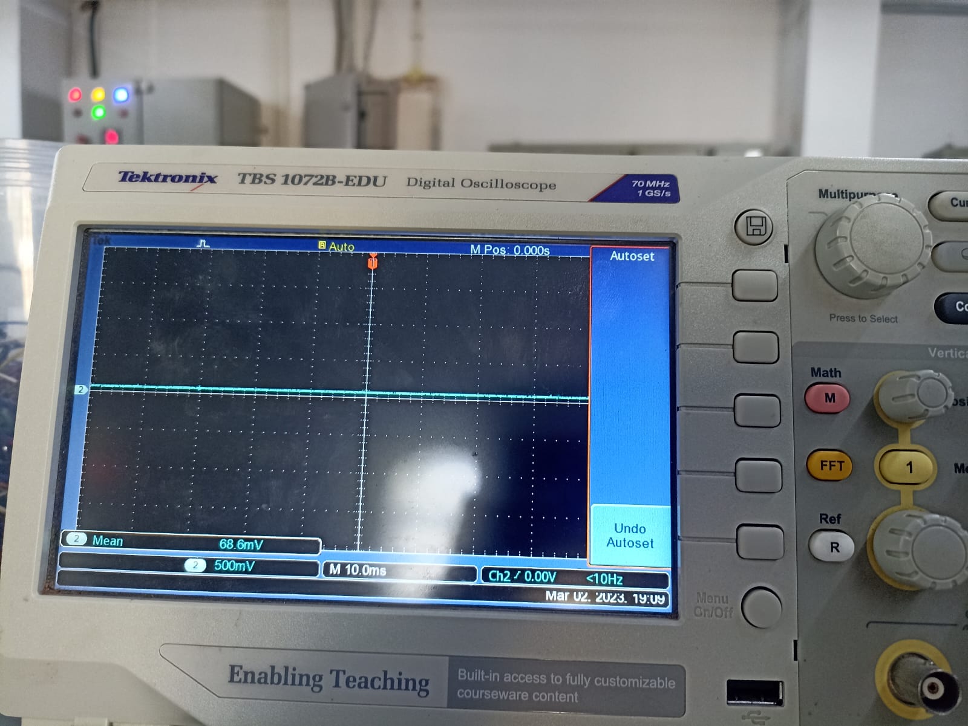
Breadboard_Simulations & Results/60V DC two stage attenuator.jpeg
