sprabha5/High-Voltage-Isolated-Differential-Probe/Breadboard_Simulations & Results/80mv to isolation amplifier.jpeg

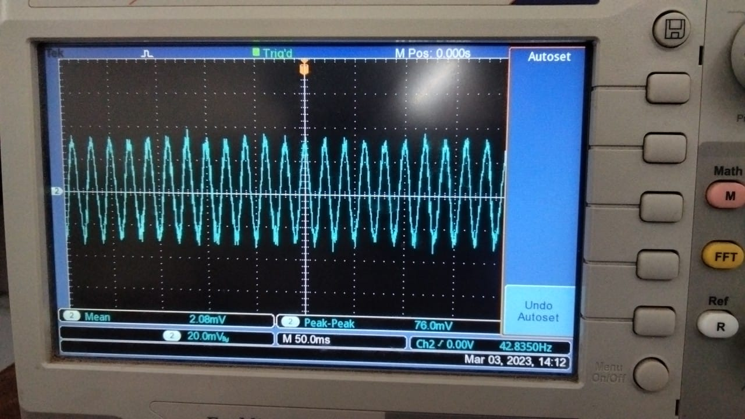
Breadboard_Simulations & Results/80mv to isolation amplifier.jpeg
