sprabha5/High-Voltage-Isolated-Differential-Probe/Breadboard_Simulations & Results/480(peak to peak) input voltage to attenuator.jpeg

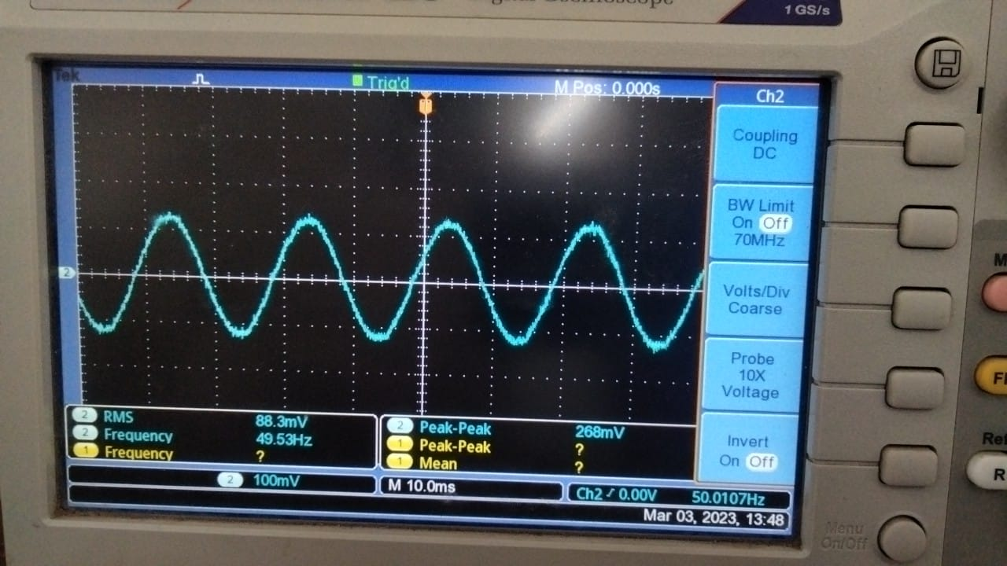
Breadboard_Simulations & Results/480(peak to peak) input voltage to attenuator.jpeg
