sprabha5/High-Voltage-Isolated-Differential-Probe/Breadboard_Simulations & Results/Attenuator.jpeg

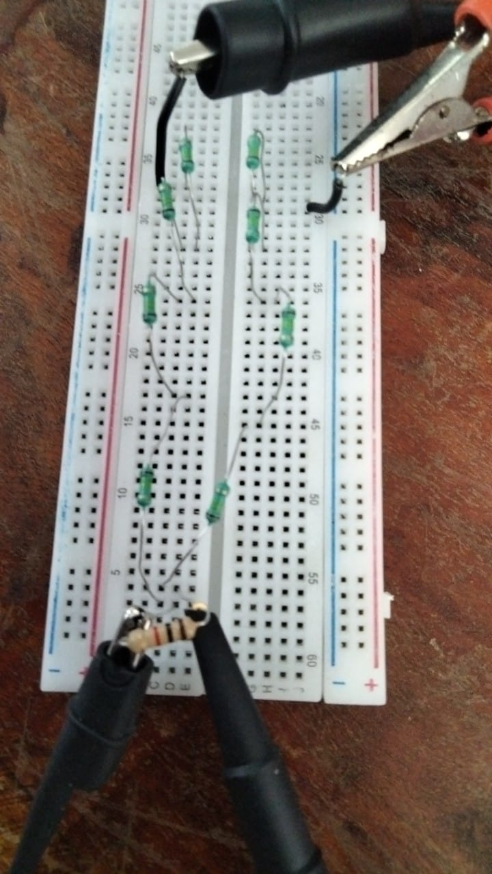
Breadboard_Simulations & Results/Attenuator.jpeg
