sprabha5/High-Voltage-Isolated-Differential-Probe/Breadboard_Simulations & Results/one satge attenuator to isolation amplifier.jpeg

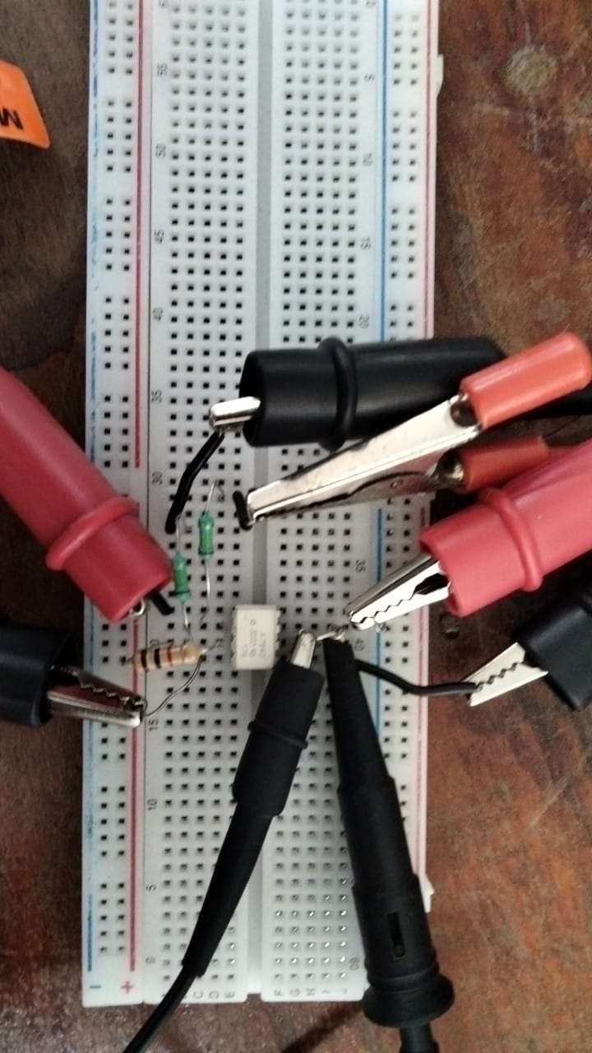
Breadboard_Simulations & Results/one satge attenuator to isolation amplifier.jpeg
