sprabha5/High-Voltage-Isolated-Differential-Probe/Breadboard_Simulations & Results/Out ,one stage 100mv input to isolaton amplifier.jpeg

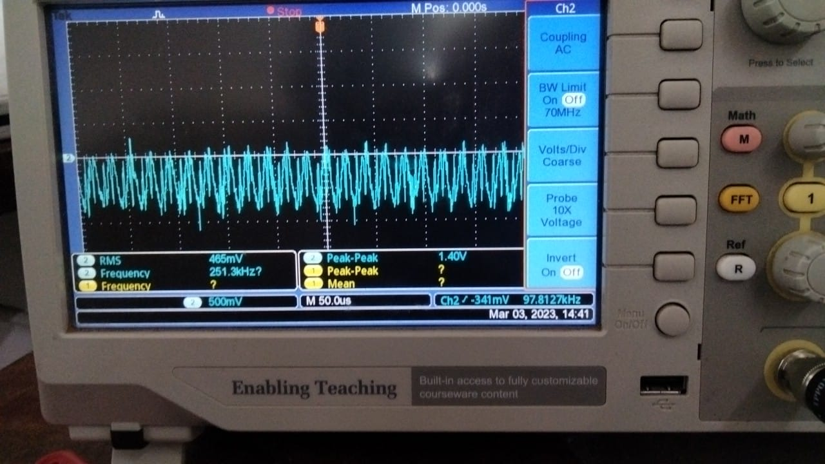
Breadboard_Simulations & Results/Out ,one stage 100mv input to isolaton amplifier.jpeg
