sprabha5/High-Voltage-Isolated-Differential-Probe/LTspice_simulations/edl_circuit (1).asc

R1: res; 0.25Meg
R2: res; 0.25Meg
R3: res; 0.25Meg
R4: res; 0.25Meg
R5: res; 0.25Meg
R6: res; 0.25Meg
R7: res; 0.25Meg
R8: res; 0.25Meg
R9: res; 50k
R10: res; 50k
R11: res; 50k
R12: res; 1.05k
R13: res; 50k
R14: res; 50k
R15: res; 50k
R16: res; 50k
R18: res; 50k
R19: res; 50k
U1: AMC1301
U2: LF356_NS
U3: LF356_NS
U4: LF356_NS
V1: voltage; 5
V2: voltage; SINE(300 300 500k 1p); AC 10
V3: voltage; 15
V4: voltage; -15
V5: voltage; -15
V6: voltage; 5
V7: voltage; 15
V8: voltage; -15
V9: voltage; 15
V10: voltage; 0
Named nets: 0, Vin+, Vin-, Vout+, Vout-, differential_amplifier, inverting_amplifier_of_gain_1/8, isolation_amplifier_gain_8, input_attenuater_1/10000
.tran 0 10u 0 0.01u
